marcorispoli/PCB336/README.md

NOTE DI DEBUG

17/04/2026

- Manca in Lista Parti L1.
 Aggiunto manualmente
