marcorispoli/PCB336/ESECUTIVI/LP25-336-0_ASSY00_Rev00.xlsx

Sheet: 25-336-0
LISTA PARTI 25-336-0 |  |  |  |  |  |  | DATA 19/02/2026
Pos. | Qtà | Rif | Descrizione | Value | PN Costruttore | PN Fornitore (MOUSER) | Costruttore | Package | PcbFootprint
1 | 2 | C1,C8 | MLCC - SMD/SMT 50V 0.1uF X7R 0603 10% | 100nF | C0603C104K5RACTU | 80-C0603C104K5R | KEMET |  | SMD0603
2 | 2 | C2,C5 | Cond. ELT Alluminio 50V D=8 THT | 33uF | 870575774002 | 710-870575774002 | WUERTH |  | EV8
3 | 2 | C3,C7 | MLCC - SMD/SMT 50V 1uF X7R 1206 10% | 1uF | C1206C105K5RAC | 80-C1206C105K5RAC | KEMET |  | SMD1206
4 | 1 | C4 | MLCC - SMD/SMT 50V 0.1uF X7R 0603 10% | 100nF | CC1206JRX7R9BB104 | 603-C1206JRX7R9BB104 | YAGEO |  | SMD1206
5 | 1 | C6 | MLCC - SMD/SMT 50V 10uF X7R 2220 10% | 10uF | 885012214005 | 710-885012214005 | WUERTH |  | SMD2220
6 | 1 | C9 | MLCC - SMD/SMT 50V 0.022uF X7R 0603 5% | 22nF | C0603C223J5RAC | 80-C0603C223J5RAC | KEMET |  | SMD0603
7 | 1 | C10 | MLCC - SMD/SMT 50V 470nF X7R 0603 5% | 470nF | CGA3E3X7R1H474KB | 810-CGA3E3X7R1H474KB | TDK |  | SMD0603
8 | 1 | C11 | Cond.Multilayer X7R, 50V 1210 | 2u2F | C1210C225K5RACTU | 80-C1210C225K5R | KEMET | SMD1210 | SMD1210
9 | 1 | C12 | MLCC - SMD/SMT 50V 0.010uF X7R 0603 5% | 10nF | C0603C103K5R7867 | 80-C0603C103K5R7867 | KEMET |  | SMD0603
10 | 11 | C13,C14,C17,C27,C29,C30,C31,C32,C33,C35,C36 | MLCC - SMD/SMT 50V 0.1uF X7R 0603 10% | 100nF | C0603C104K5RACTU | 80-C0603C104K5R | KEMET | SMD0603 | SMD0603
11 | 2 | C15,C16 | MLCC - SMD/SMT 50V 1nF COG(NPO) 0603 5% | 1nF | C0603C102J5RAC | 80-C0603C102J5GAL | KEMET |  | SMD0603
12 | 2 | C18,C19 | MLCC - SMD/SMT 50V 68pF COG (NP0) 0603 2% | 68pF | C0603C680G5GACTU | 80-C0603C680G5G | KEMET | SMD0603 | SMD0603
13 | 3 | C20,C21,C24 | MLCC - SMD/SMT 50V 0.1uF X7R 0603 10% | 100nF | C0603C104K5RACTU | 80-C0603C104K5R | KEMET | SMD0603 | SMD0603
14 | 4 | C22,C23,C25,C26 | Cond.Elt.Tantalio 35V SIZE C | 4u7 | T491C475K035ATAUTO | 80-T491C475K35ATAUTO | KEMET | TNT SIZE C | ETANT-C
15 | 1 | C28 | MLCC - SMD/SMT 10V 10uF X7R 0805 10% | 10uF | C0805C106K8RACTU | 80-C0805X106K8RAUTLR | KEMET | SMD0805 | SMD0805-MET
16 | 1 | C34 | MLCC - SMD/SMT 35V 4u7F X7R 1206 10% | 4u7 | C1206C475K6RACTU | 80-C1206C475K6R | KEMET | SMD1206 | SMD1206
17 | 2 | DL1,DL2 | Diodo led smd 0805 | VERDE | APTD2012LCGCK | 604-APTD2012LCGCK | KINGBRIGHT | SMD0805 | LED0805-MET-12
18 | 1 | DL3 | Diodo led smd 0805 | BLU | APT2012LVBC/D | 604-APT2012LVBCD | KINGBRIGHT | SMD0805 | LED0805-MET-12
19 | 5 | DL4,DL5,DL6,DL7,DL8 | Diodo led smd 0805 KP-2012YD | GIALLO | APTD2012LSYCK | 604-APTD2012LSYCK | KINGBRIGHT | SMD0805 | LED0805-MET-12
20 | 1 | DL9 | Diodo led smd 0805 APTD2012LSURCK | ROSSO | APTD2012LSURCK | 604-APTD2012LSURCK | KINGBRIGHT | SMD0805 | LED0805-MET-12
21 | 1 | D1 | Diodi e raddrizzatori Schottky HV Power Schottky 100Vrrm 2x10A 0.85V | MBR20100CT-G1 | MBR20100CT-G1 | 621-MBR20100CT-G1 | DIODES |  | TO220-NUM
22 | 1 | D2 | Zener Diodes ZENER 5W 51V | CZRB5369B-HF | CZRB5369B-HF | 750-CZRB5369B-HF | COMCHIP |  | SMB-2_1
23 | 1 | D3 | Diodi e raddrizzatori Schottky 1A 100V | MBRS1100T3G | MBRS1100T3G | 863-MBRS1100T3G | ONSEMI |  | SMB-2_1
24 | 1 | D4 | Diodi Zener ZENER DIODE 27V SOD123 | MMSZ5254CHE3_A-08 | MMSZ5254CHE3_A-08 | 78-MMSZ5254CHE3_A-08 | VISHAY |  | SOD123_2-1
25 | 1 | D5 | Diodi Zener ZENER DIODE 12V SOD123 | MMSZ5242C-HE3_A-08 | MMSZ5242C-HE3_A-08 | 78-MMSZ5242CHE3_A-08 | VISHAY |  | SOD123_2-1
26 | 1 | D6 | ESD Protection compatible with CAN BUS | ESD2CAN24DBZRQ1 | ESD2CAN24DBZRQ1 | 595-ESD2CAN24DBZRQ1 | TEXAS | SMD | SOT23-123
27 | 3 | D7,D8,D9 | Raddrizzatori 1.0A Rectifier UF Recovery | ES1B | ES1B | 512-ES1B | ONSEMI |  | SMA-1/2
28 | 1 | FL3 | Circuiti filtro EMI 40 DB 50V 15A LEADED | BNX012-01 | BNX012-01 | 81-BNX012-01 | MURATA |  | BNX012-01-MURATA_NEW
29 | 1 | F1 | FUSIBILE +PORTAFUSIBILE 0154005.DRT | 5A | 0154005.DRT | 576-0154005.DRT | LITTELFUSE |  | LITTELFUSE-154
30 | 2 | J1,J2 | CONN.HEADER 2X2 DRITTO P2 | NANO-FIT 105312-1104 | 105312-1104 | 538-105312-1104 | MOLEX |  | 1053121104-MOLEX
31 | 1 | J3 | Molex Minifit 2x1 | 46999-0138-MOLEX | 46999-0138 | 538-46999-0138 | Molex | Minifit46999-0138 | MOLEX-39281023
32 | 1 | J4 | Connettore ULTRAFIT 2 x 4 P.3.5 | MOLEX 172298-1108 | 172298-1108 | 538-172298-1108 | MOLEX | THT | 1722981108-MOLEX
33 | 1 | J5 | Header boxed IDC dritto 2 X 3 P.2.54 | 61200621621 | 61200621621 | 710-61200621621 | WUERTH | THT | 61200621621-WE
34 | 1 | J6 |  | HEADER 5 |  |  |  |  | 5SIP100 | NON MONTARE
35 | 3 | K1,K2,K4 | RELE' 24V 6A DOPPIO | 32.21.7.4000 | 32.21.7.4000 | FARNEL: 4244646 | FINDER |  | 32.21- FINDER
36 | 1 | K3 | RELE' STATO SOLIDO SMD | CPC1017NTR | CPC1017NTR | 849-CPC1017NTR | IXYS |  | CPC1017N-CLARE
37a | 1 | L1 | Induttori accoppiati WE-CFWI Cpld Flatwr 10uH 13A 13.9mOhms | 10uH | 74485540101 | 710-74485540101 | WUERTH | 74485540101 | WE-74485540101
37b | 1 | L2 | Filtro Modo Comune x CAN BUS | DLW32SH101XF2L | DLW32SH101XF2L | 81-DLW32SH101XF2L | MURATA | DLW32SH101XF2L | DLW32S_MURATA
38 | 1 | L3 | Induttore 8.2uH | 8.2uH | SRR4528A-8R2Y | RS:1765964 MOUSER: 652-SRR4528A-8R2Y FARNELL: | BOURNS | 5X5MM SMD | SRR4528A-BOURNS | (NOTA: trovare una alternativa)
39 | 2 | L4,L5 | Ferrite Bead | BLM18BD102 | BLM18BD102SN1D | 81-BLM18BD102SN1D | MURATA | SMD0603 | SMD0603
40 | 11 | Q1,Q3,Q4,Q5,Q6,Q7,Q8,Q9,Q10,Q11,Q12 | MOSFET CANALE N | 2N7002LT1G | 2N7002LT1G | 863-2N7002LT1G | ON | SOT23 | SOT23-123
41 | 1 | Q2 | MOSFET N-Ch 200V 36A TDSON-8 OptiMOS 3 | BSC320N20NS3GATMA1 | BSC320N20NS3GATMA1 | 726-BSC320N20NS3GATM | INFINEON | TDSON-8 | PG-TDSON-8-INFINEON
42 | 5 | R1,R43,R45,R46,R47 | Resistore thick film 1/8W 1% 0603 | 20K | AC0603FR-0720KL | 603-AC0603FR-0720KL | VARI | SMD0603 | SMD0603
43 | 1 | R2 | Resistore thick film 1/8W 1% 0603 | 38K3 | AC0603FR-0738K3L | 603-AC0603FR-0738K3L | VARI | SMD0603 | SMD0603
44 | 4 | R3,R4,R18,R19 | Resistore thick film 1/8W 1% 0603 | 4K7 | AC0603FR-074K7L | 603-AC0603FR-074K7L | VARI | SMD0603 | SMD0603
45 | 1 | R5 | Resistore thick film 1/8W 1% 0603 | 1Meg | AC0603DR-071ML | 603-AC0603DR-071ML | VARI | SMD0603 | SMD0603
46 | 7 | R6,R16,R17,R22,R24,R30,R49 | Resistore thick film 1/8W 1% 0603 | 10K | RC0603FR-0710KL | 603-RC0603FR-0710KL | VARI | SMD0603 | SMD0603
47 | 2 | R7,R8 | Resistore thick film 250mW 1% 1206 | 2R | RCC12062R00FKEA | 71-RCC12062R00FKEA | VISHAY | SMD1206 | SMD1206
48 | 1 | R9 | Resistore thick film 1/8W 1% 0603 | 100K | RC0603FR-07100KL | 603-RC0603FR-07100KL | VARI | SMD0603 | SMD0603
49 | 4 | R10,R11,R39,R48 | Resistore thick film 1/8W 1% 0603 | 1K | RC0603FR-071KL | 603-RC0603FR-071KL | VARI | SMD0603 | SMD0603
50 | 1 | R12 | Resistore thick film 1/8W 1% 0603 | 30K | AC0603DR-0730KL | 603-AC0603DR-0730KL | VARI | SMD0603 | SMD0603
51 | 1 | R13 | Resistore thick film 1/8W 1% 0603 | 196K | AC0603FR-07196KL | 603-AC0603FR-07196KL | VARI | SMD0603 | SMD0603
52 | 2 | R14,R15 | Resistore thick film 1W 1% SMD2010 | 0R01 | PE2010FKF7W0R01L | 603-PE2010FKF7W0R01L | YAGEO | SMD2010 | SMD2010
53 | 2 | R20,R21 | Resistore thick film 1/8W 1% 0603 | 0R | RC0603JR-070RL | 603-RC0603JR-070RL | VARI | SMD0603 | SMD0603
54 | 2 | R23,R27 | Resistore thick film 1/8W 1% 0603 | 560R | AC0603FR-07560RL | 603-AC0603FR-07560RL | VARI | SMD0603 | SMD0603
55 | 2 | R25,R28 | Resistore thick film 1/8W 1% 0603 | 2K7 | AC0603FR-072K7L | 603-AC0603FR-072K7L | VARI | SMD0603 | SMD0603
56 | 2 | R26,R29 | Resistore thick film 1/8W 1% 0603 | 5K6 | AC0603FR-075K6L | 603-AC0603FR-075K6L | VARI | SMD0603 | SMD0603
57 | 1 | R31 | Resistore thick film 1/8W 1% 0603 | 33R | AC0603FR-0733RL | 603-AC0603FR-0733RL | VARI | SMD0603 | SMD0603
58 | 2 | R32,R37 | Resistore thick film 1/8W 1% 0603 | 120R | RC0603FR-13120RL | 603-RC0603FR-13120RL | VARI | SMD0603 | SMD0603
58b | 1 | R35 | Resistore thick film 1/8W 1% 0603 | 120R | RC0603FR-13120RL | 603-RC0603FR-13120RL | VARI | SMD0603 | SMD0603 | NON MONTARE
59 | 3 | R33,R34,R36 | Resistore thick film 1/8W 1% 0603 | 470R | RC0603FR-07470RL | 603-RC0603FR-07470RL | VARI | SMD0603 | SMD0603
60 | 1 | R38 | Resistore thick film 1/8W 1% 0603 | 3K3 | RC0603FR-133K3L | 603-RC0603FR-133K3L | VARI | SMD0603 | SMD0603
61 | 1 | R40 | Resistore thick film 1/4W 1% 0603 | 0R | RC1206FR-070RL | 603-RC1206FR-070RL | VARI | SMD1206 | SMD1206
62 | 2 | R41,R42 | Resistore thick film 1W 1% 2512 | 4R7 | AC2512JK-074R7L | 603-AC2512JK-074R7L | VARI | SMD2512 | SMD2512
63 | 1 | R44 | Resistore thick film 1/8W 1% 0603 | 100R | TR0603MR-07100RL | 603-TR0603MR-07100RL | VARI | SMD0603 | SMD0603
64 | 1 | R50 | Resistore thick film 1/8W 1% 0603 | 330R | AC0603FR-07330RL | 603-AC0603FR-07330RL | VARI | SMD0603 | SMD0603
65 | 7 | R51,R53,R54,R55,R56,R57,R58 | Resistore thick film 1/8W 1% 0603 | 680R | RC0603FR-07680RL | 603-RC0603FR-07680RL | VARI | SMD0603 | SMD0603
66 | 7 | R52,R59,R60,R61,R62,R63,R64 | Resistore thick film 1/8W 1% 0603 | 33K | RC0603FR-1033KL | 603-RC0603FR-1033KL | VARI | SMD0603 | SMD0603
67 | 7 | TP1,TP2,TP3,TP4,TP5,TP6,TP7 | Torretta x Test Point foro pcb 1mm | 20-2137 | 20-2137 | FARNELL:8731128 RS:101-2391 | TRUE | THT | TESTPOINT_1MM | NON MONTARE
68 | 1 | U1 | Board Mount Current Sensors 80ARMS 500kHz Hall-e ffect current sensor | TMCS1126C5BQDVGR | TMCS1126C5BQDVGR | 595-TMCS1126C5BQDVGR | TEXAS |  | DVG0010A
69 | 1 | U2 | Controller di commutazione Low-IQ, 2MHz 60V iso lated SEPIC FLYBACK | LT8357EMSE#PBF | LT8357EMSE#PBF | 584-LT8357EMSE#PBF | ANALOG DEVICE | MSOP-12 | MSE-12 PIN-EP
70 | 2 | U3,U4 | Optoisolatore singolo | TCMT1103 | TCMT1103 | 782-TCMT1103 | VISHAY | HALF PITCH MINI-FLAT | SSOP4
71 | 2 | U5,U6 | Amplificatori operazionali - Amp. op. Dual Low Power | LM358PT | LM358P | 511-LM358P | ST |  | SOG.65M/8/WG6.40/L3.00
72 | 1 | U7 | CAN TRANSCEIVER | TJA1050T | TJA1050T | 771-TJA1050T/CM,118 | NXP | SOIC-8 | SO8
73 | 1 | U8 | DC/DC 5V 500mA | TSR 0.5-2450 | TSR 0.5-2450 | 495-TSR0.5-2450 | TRACO POWER | THT | TSR-0.5-TRACO
74 | 1 | U9 | 3.3VDC LDO | NCP1117ST33T3G | NCP1117ST33T3G | 863-NCP1117ST33T3G | ON | SOT223 | SOT223-1234
75 | 1 | U10 | 32bit ARM 4F 1MB Flash, 256K Ram, 2xCAN-FD | SAME51J20A-A | SAME51J20A-A | 556-ATSAME51J20A-AF | MICROCHIP | TQFP | QUAD.50M/64/WG12.00
76 | 1 | RAD1 | DISSIPATORE PER TO220 | AAVID 513102B02500G | 513102B02500G | 532-513102B25 | AAVID

Sheet: Revision
LISTA PARTI PCB/25-336-0 | REV 00
ASSY_00
Change Log | Rev | Descrizione
2026-02-23 | 0 | Prima emissione: - R35: (can bus) non montare. - Test points: non montare, si usano solo le piazzole - J6: non momtare. E' una predisposizione per una scheda aggiuntiva per la tensione di griglia
