marcorispoli/PCB336/KiCad/PCB336.csv

# | Qty | Qty x3 schede | N acquisto | Value | Mouser Part Number | Farnell Part Number
1 | 28 | 84 | 85 | 100nF | 71-VJ0805Y104KXACWBC
2 | 1 | 3 | 5 | 4u7 | 80-C1206C475K6R
3 | 2 | 6 | 10 | 10nF | 80-C0805C103J5G
4 | 1 | 3 | 5 | 10uF | 581-KGM21AR51A106MU
5 | 2 | 6 | 10 | 10uF | 80-C1206C106K3PAC
6 | 9 | 27 | 30 | 1uF | 187-CL31A105KB9LNNC
7 | 1 | 3 | 5 | 100pF | 581-06035U101KAT2A
8 | 1 | 3 | 5 | 470pF | 80-C0603C471J5GAUTO
9 | 2 | 6 | 10 | 100uF | 667-EEU-EE2D101S
10 | 1 | 3 | 5 | 47nF | 581-KAM21BR71H473KT
11 | 8 | 24 | 25 | GREEN | 859-LTST-C171TGKT
12 | 1 | 3 | 5 | BLUE | 859-LTST-C170TBKT
13 | 1 | 3 | 5 | RED | 859-LTST-C170KRKT
14 | 8 | 24 | 25 | YELLOW | 859-LTST-C170KSKT
15 | 10 | 30 | 30 | 1N4148W | 637-1N4148W
16 | 4 | 12 | 15 | ES1A | 512-ES1A
17 | 1 | 3 | 5 | 39-29-9043 | 538-39-29-9043
18 | 1 | 3 | 5 | Piazzolato
19 | 4 | 12 | 15 | 32.21.7.024.4000 |  | 4244646
20 | 11 | 33 | 35 | 2N7002LT1G | 863-2N7002LT3G
21 | 3 | 9 | 10 | 4K7 | 71-CRCW0805-4.7K-E3
22 | 1 | 3 | 5 | 866R | 603-RC0805FR-07866RL
23 | 14 | 42 | 45 | 10K | 603-RC0603FR-0710KL
24 | 1 | 3 | 5 | 330R | 603-AF0603FR-07330RL
25 | 3 | 9 | 10 | 1K | 603-RC0603FR-101KL
26 | 10 | 30 | 30 | 680R | 603-AF0603FR-07680RL
27 | 6 | 18 | 20 | 33K | 603-RV0603JR-0733KL
28 | 6 | 18 | 20 | 5K6 | 603-AF0603FR-075K6L
29 | 1 | 3 | 5 | 220R | 603-RC0603FR-07220RL
30 | 2 | 6 | 10 | 2K | 603-RE0603DRE072KL
31 | 1 | 3 | 5 | 56K | 603-AC0603FR-1356KL
32 | 2 | 6 | 10 | 2K2 | 603-AA0603FR-072K2L
33 | 2 | 6 | 10 | 4K7 | 603-RC1206FR-074K7L
34 | 2 | 6 | 10 | 200R | 603-AF0603FR-07200RL
35 | 2 | 6 | 10 | 27K | 603-AF0603FR-0727KL
36 | 2 | 6 | 10 | 86K6 | 603-RC0603FR-0786K6L
37 | 1 | 3 | 5 | 39K | 603-AF0603FR-0739KL
38 | 3 | 9 | 10 | 4K7 | 603-RC0603FR-074K7L
39 | 1 | 3 | 5 | 18K | 603-RC0603FR-1018KL
40 | 3 | 9 | 10 | 100K | 603-RC0603FR-07100KL
41 | 1 | 3 | 5 | 22K | 603-RC0603FR-1022KL
42 | 1 | 3 | 5 | 10R | 571-SMW210RJT
43 | 5 | 15 | 15 | 120R | 603-RC0603FR-10120RL
44 | 1 | 3 | 5 | 1K | 603-RC0805FR-071KL
45 | 1 | 3 | 5 | 33R | 603-RC0805FR-0733RL
46 | 1 | 3 | 5 | 0R | 603-RC0603JR-070RL
47 | 2 | 6 | 10 | 2K2 | 603-AF0805JR-072K2L
48 | 1 | 3 | 5 | 680R | 603-AF0805FR-07680RL
49 | 1 | 3 | 5 | 20K | 652-3296W-1-203LF
50 | 1 | 3 | 5 | 5K | 652-3296W-1-502LF
51 | 1 | 3 | 5 | TF-108
52 | 1 | 3 | 5 | NCP1117ST33T3G | 863-NCP1117ST33T3G
53 | 1 | 3 | 5 | ATSAME51J20A-A | 556-ATSAME51J20A-AF
54 | 1 | 3 | 5 | PCB319-2
55 | 1 | 3 | 5 | TME-0505S
56 | 1 | 3 | 5 | MAX22246CAWA_V+ | 700-MAX22246CAWA/V+
57 | 2 | 6 | 10 | ADM4857ARZ-REEL7 | 584-ADM4857ARZ-R7
58 | 1 | 3 | 5 | ADUM3195BRQZ | 584-ADUM3195BRQZ
59 | 1 | 3 | 5 | SRR4828A-8R2Y | 652-SRR4828A-8R2Y
60 | 10 | 30 | 30 | 4.7uF | 80-T491C475K035
61 | 6 | 18 | 20 | 5000 | 534-5000
62 | 3 | 9 | 10 | 5001 | 534-5001
63 | 6 | 18 | 20 | 5002 | 534-5001
64 | 2 | 6 | 10 | 0154003.DRT | 576-0154003.DRT
65 | 1 | 3 | 5 | XR2206CP-F | 701-XR2206CP-F
66 | 1 | 3 | 5 | MCP4821-E/MS | 579-MCP4821-E/MS
67 | 1 | 3 | 5 | 105310-2210 | 538-105310-2210
68 | 2 | 6 | 10 | 105312-1104 | 538-105312-1104
69 | 1 | 3 | 5 | MOLEX_172298-1108 | 538-172298-1108
70 | 2 | 6 | 10 | BLM18BD102SN1D | 81-BLM18BD102SN1D
71 | 2 | 6 | 10 | BNX012-01 | 81-BNX012-01
72 | 2 | 6 | 10 | BAT754S,215 | 771-BAT754S-T/R
73 | 1 | 3 | 5 | MMBZ6V2AL,215 | 771-MMBZ6V2AL215
74 | 1 | 3 | 5 | NJM78L12UA-TE1 | 513-NJM78L12UA-TE1
75 | 1 | 3 | 5 | NJM79L12SU3-TE1 | 513-NJM78L12UA-TE1
76 | 1 | 3 | 5 | NJM78L05UA-TE1 | 513-NJM78L05UA-TE1
77 | 1 | 3 | 5 | TJA1050T_CM,118 | 771-TJA1050T/CM118
78 | 2 | 6 | 10 | SK56C | 821-SK56C
79 | 1 | 3 | 5 | ESD2CAN24DBZRQ1 | 595-ESD2CAN24DBZRQ1
80 | 1 | 3 | 5 | ISO6742FDWR | 595-ISO6742FDWR
81 | 1 | 3 | 5 | LM1458MX_NOPB | 926-LM1458MX/NOPB
82 | 1 | 3 | 5 | LM358BAIDR | 595-LM358BAIDR
83 | 1 | 3 | 5 | TSR_0.5-2450 | 495-TSR0.5-2450
84 | 1 | 3 | 5 | 61200621621 | 710-61200621621
85 | 8 | 24 | 25 | 33uF | 710-870575774002
86 | 1 | 3 | 5 | 470pF | 710-8853522110011
