marcorispoli/PCB336/KiCad/METSTEP/XR2206CP-F.stp

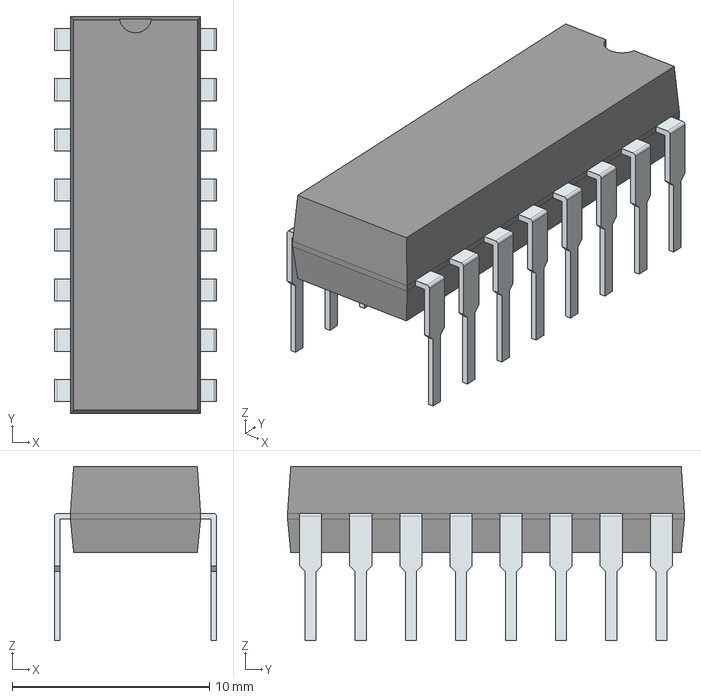
[picture p1: CAD file, 2026-08-05]
KiCad/METSTEP/XR2206CP-F.stp
8.22 x 20.1 x 8.83 mm
PinsArrayLR
