marcorispoli/PCB336/KiCad/PCB336/ESECUTIVI/PCB336-In2_Cu.dxf

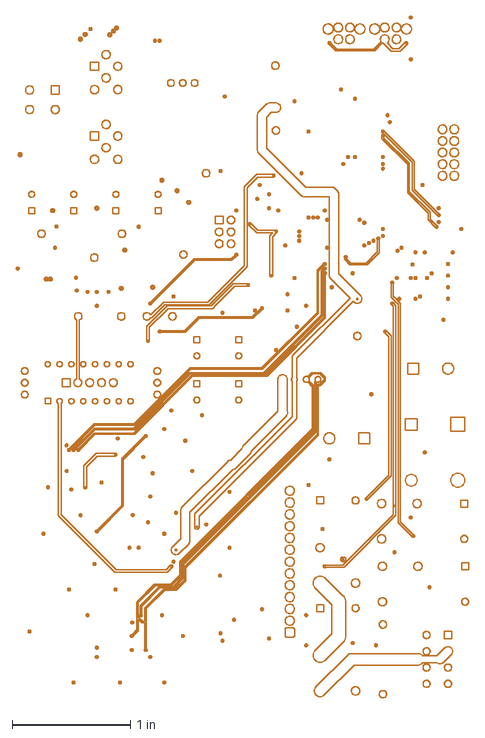
[picture p2: CAD file, 2026-09-14]
KiCad/PCB336/ESECUTIVI/PCB336-In2_Cu.dxf
3.83 x 5.77 in
