marcorispoli/PCB336/KiCad/METSTEP/BLM18BD102SN1D.stp

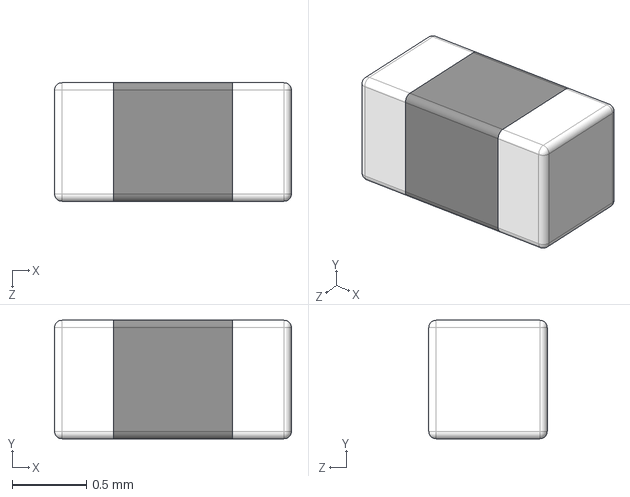
[picture p3: CAD file, 2026-08-05]
KiCad/METSTEP/BLM18BD102SN1D.stp
1.60 x 0.8 x 0.8 mm
