marcorispoli/PCB336/KiCad/PCB336/ESECUTIVI/PCB336-Edge_Cuts.dxf

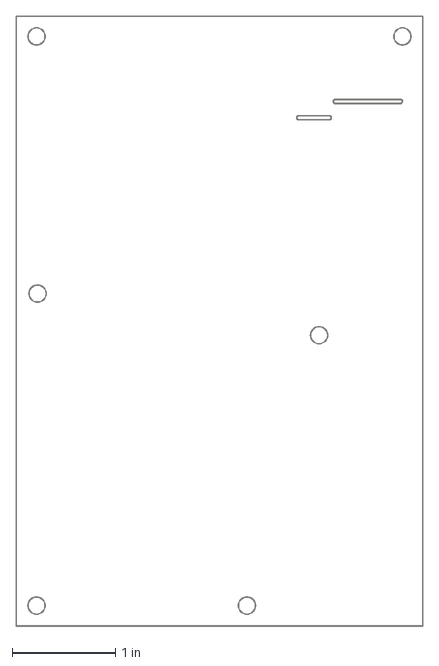
[picture p4: CAD file, 2026-09-14]
KiCad/PCB336/ESECUTIVI/PCB336-Edge_Cuts.dxf
3.94 x 5.91 in
