marcorispoli/PCB336/KiCad/METSTEP/uCProg_61200621621.stp

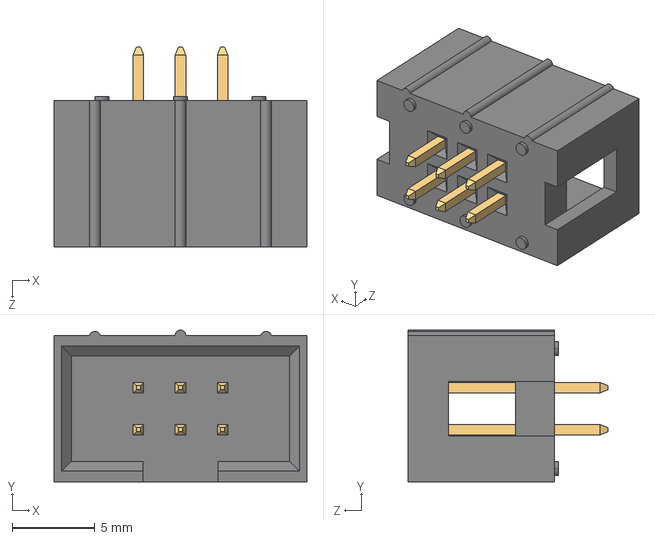
[picture p5: CAD file, 2026-08-05]
KiCad/METSTEP/uCProg_61200621621.stp
15.3 x 9.18 x 12.1 mm
6120xx21621_PIN x 6
