marcorispoli/PCB336/KiCad/METSTEP/SRR4828A-8R2Y.stp

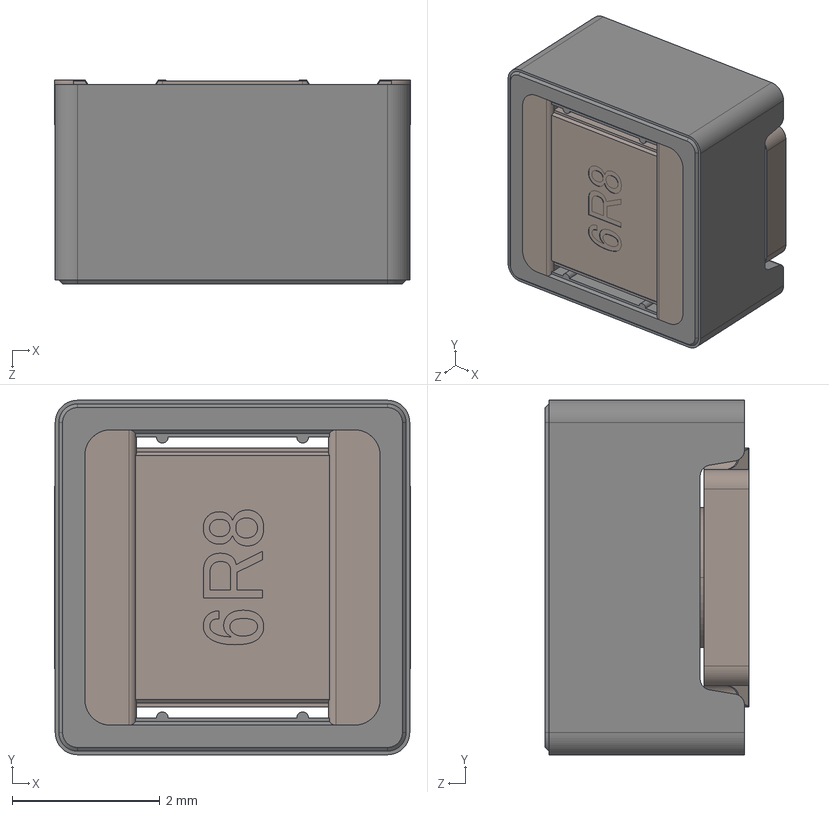
[picture p6: CAD file, 2026-08-03]
KiCad/METSTEP/SRR4828A-8R2Y.stp
4.82 x 4.80 x 2.76 mm
