marcorispoli/PCB336/KiCad/METSTEP/NJM78L12UA-TE1.stp

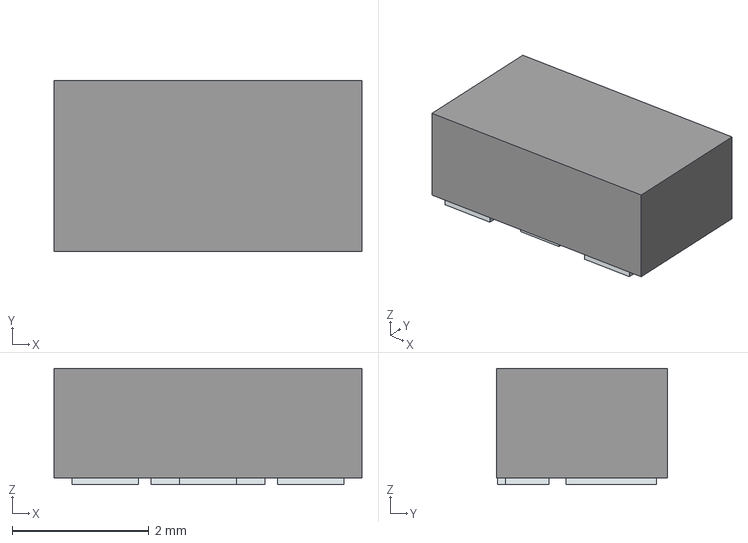
[picture p7: CAD file, 2026-08-03]
KiCad/METSTEP/NJM78L12UA-TE1.stp
4.50 x 2.50 x 1.70 mm
Pins
