marcorispoli/PCB336/KiCad/METSTEP/39-29-9043.stp

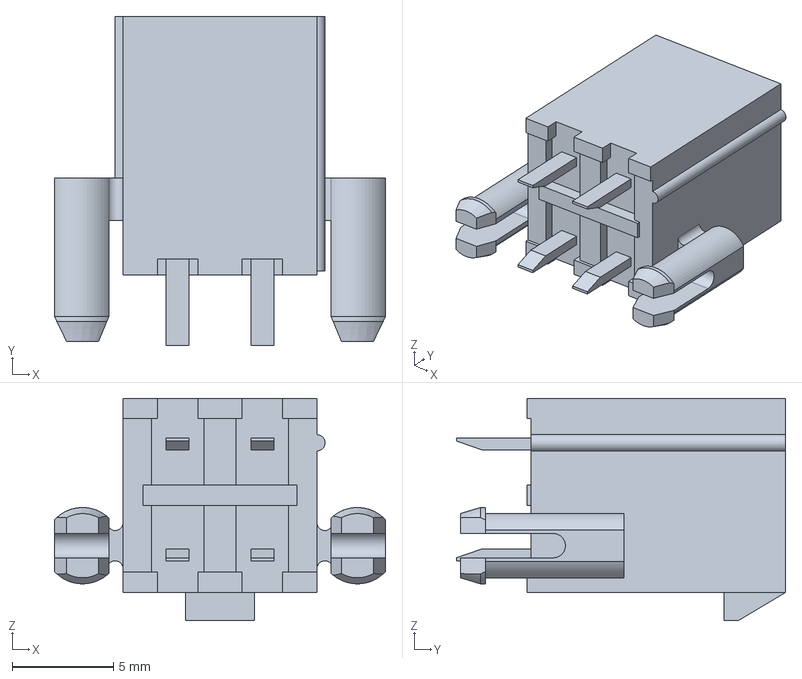
[picture p8: CAD file, 2026-08-03]
KiCad/METSTEP/39-29-9043.stp
16.4 x 16.3 x 11.0 mm
