marcorispoli/PCB336/KiCad/METSTEP/BNX012-01.stp

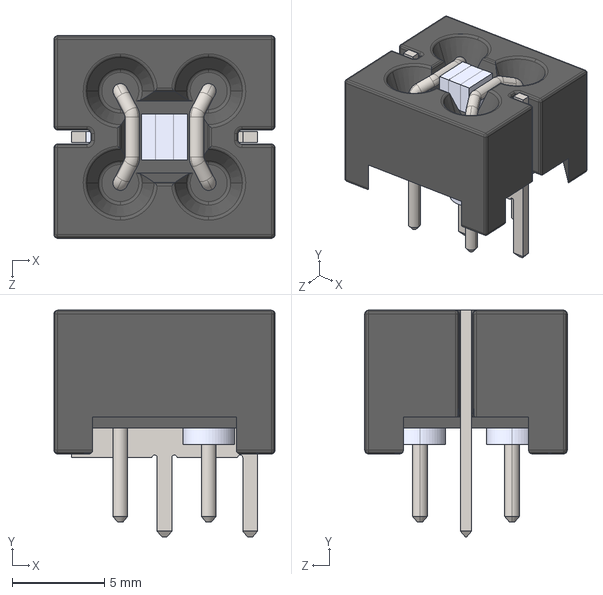
[picture p9: CAD file, 2026-08-03]
KiCad/METSTEP/BNX012-01.stp
12.0 x 12.3 x 11.0 mm
