marcorispoli/PCB336/KiCad/METSTEP/Littlefuse_serie_xxx154.DRT.stp

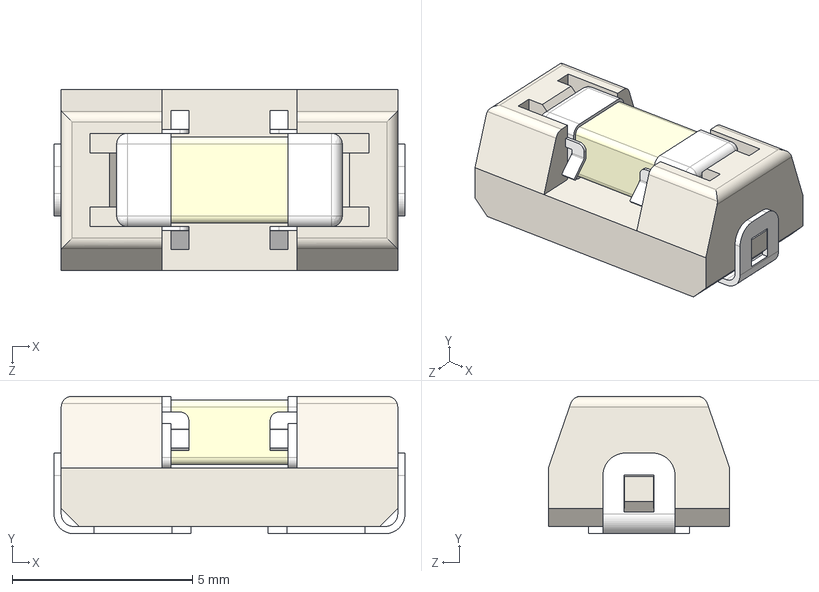
[picture p10: CAD file, 2026-08-03]
KiCad/METSTEP/Littlefuse_serie_xxx154.DRT.stp
9.73 x 3.81 x 5.03 mm
0154002.DR_2
0154002.DR_8
0154002.DR_4
0154002.DR_5
0154002.DR_9
0154002.DR_1
0154002.DR_6
0154002.DR
0154002.DR_7
0154002.DR_3
