marcorispoli/PCB336/KiCad/METSTEP/WCAP-HTG5_D8_H9_P3.5.stp

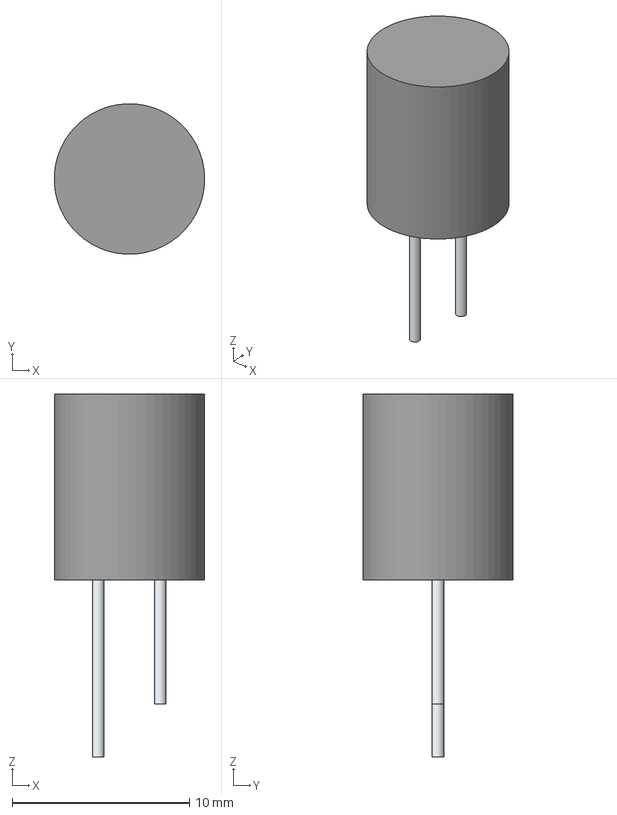
[picture p11: CAD file, 2026-08-03]
KiCad/METSTEP/WCAP-HTG5_D8_H9_P3.5.stp
8.49 x 8.50 x 20.5 mm
SimpleBody
Pin1
Pin2
