marcorispoli/PCB336/KiCad/METSTEP/TSR_0.5-2450.stp

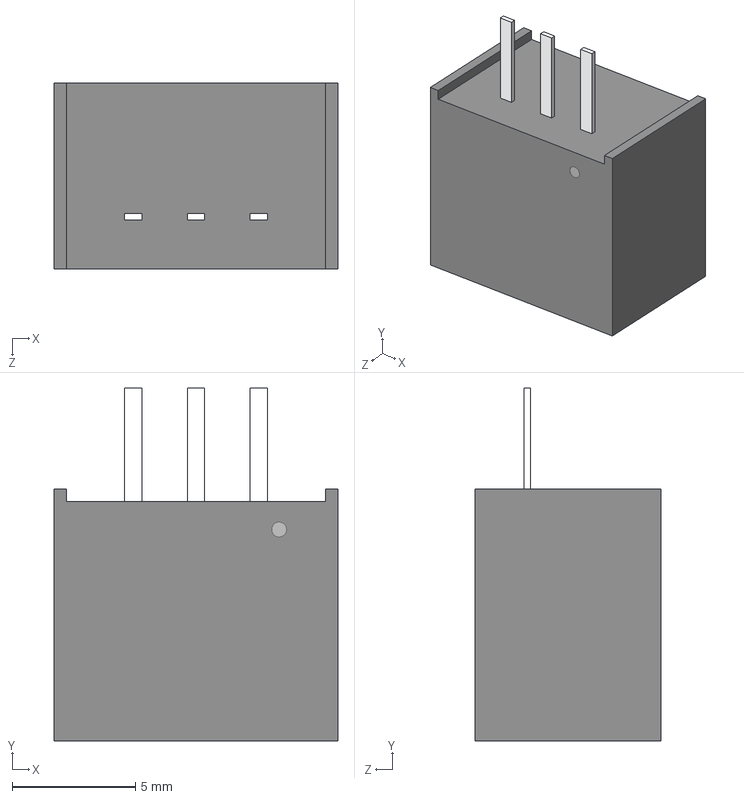
[picture p12: CAD file, 2026-08-03]
KiCad/METSTEP/TSR_0.5-2450.stp
11.5 x 14.3 x 7.55 mm
