marcorispoli/PCB336/KiCad/METSTEP/TP_5001.stp

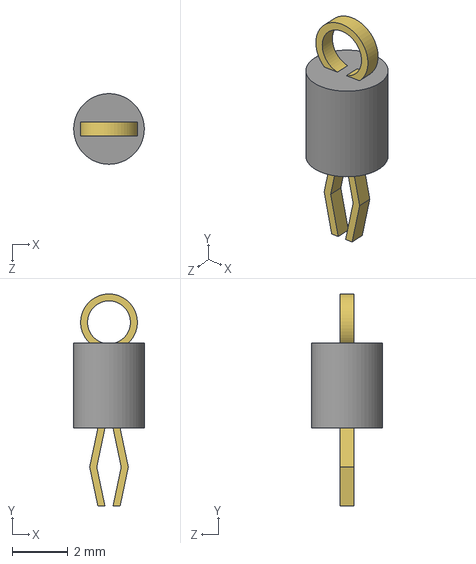
[picture p13: CAD file, 2026-08-03]
KiCad/METSTEP/TP_5001.stp
2.54 x 7.62 x 2.54 mm
