marcorispoli/PCB336/KiCad/METSTEP/T491C475K035AT.stp

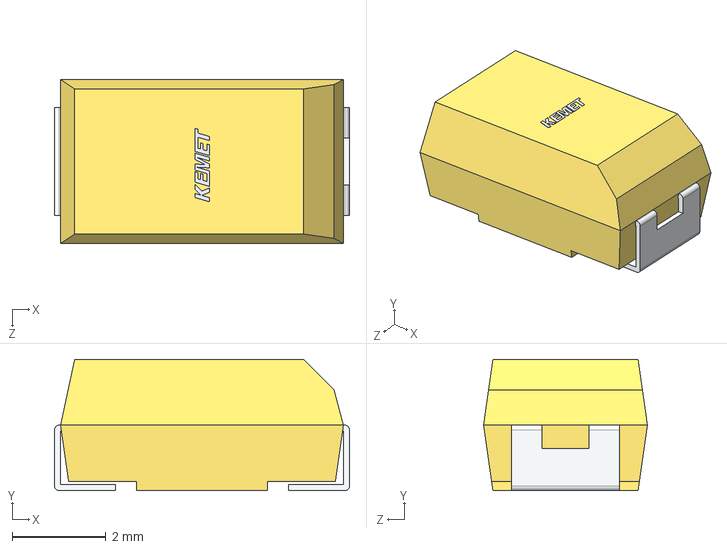
[picture p14: CAD file, 2026-08-03]
KiCad/METSTEP/T491C475K035AT.stp
6.30 x 2.81 x 3.50 mm
