marcorispoli/PCB336/KiCad/METSTEP/39-29-6108.stp

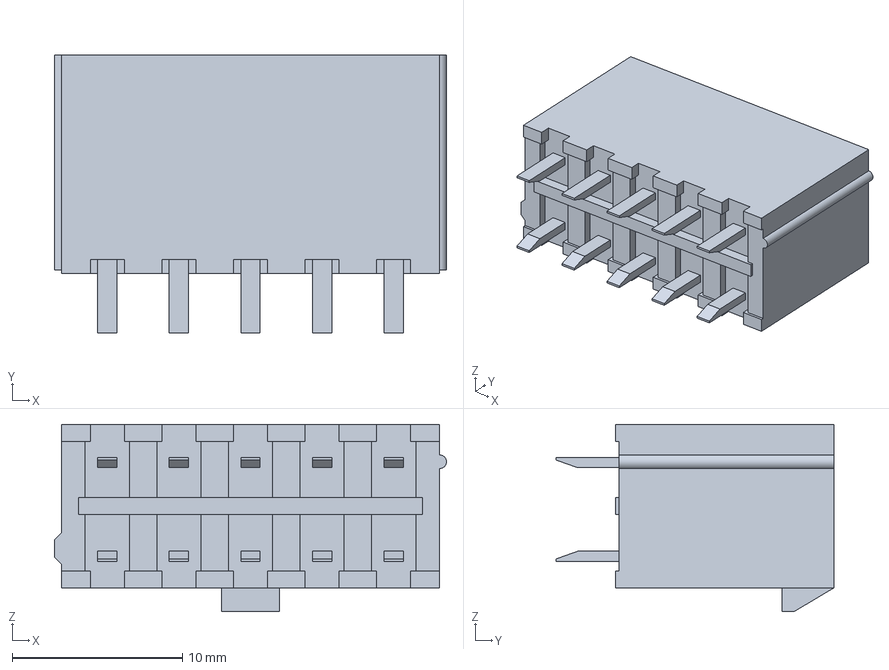
[picture p15: CAD file, 2026-08-03]
KiCad/METSTEP/39-29-6108.stp
23.0 x 16.3 x 11.0 mm
