marcorispoli/PCB336/KiCad/METSTEP/Nanofit-10-nolock.stp

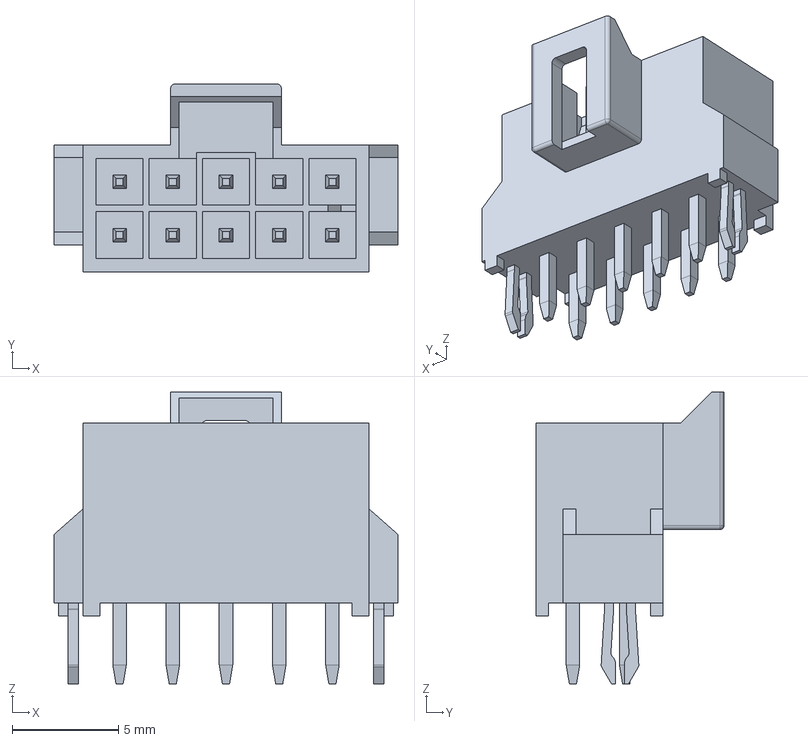
[picture p16: CAD file, 2026-08-03]
KiCad/METSTEP/Nanofit-10-nolock.stp
16.2 x 8.84 x 13.7 mm
