marcorispoli/PCB336/KiCad/METSTEP/phoenix_1986097.stp

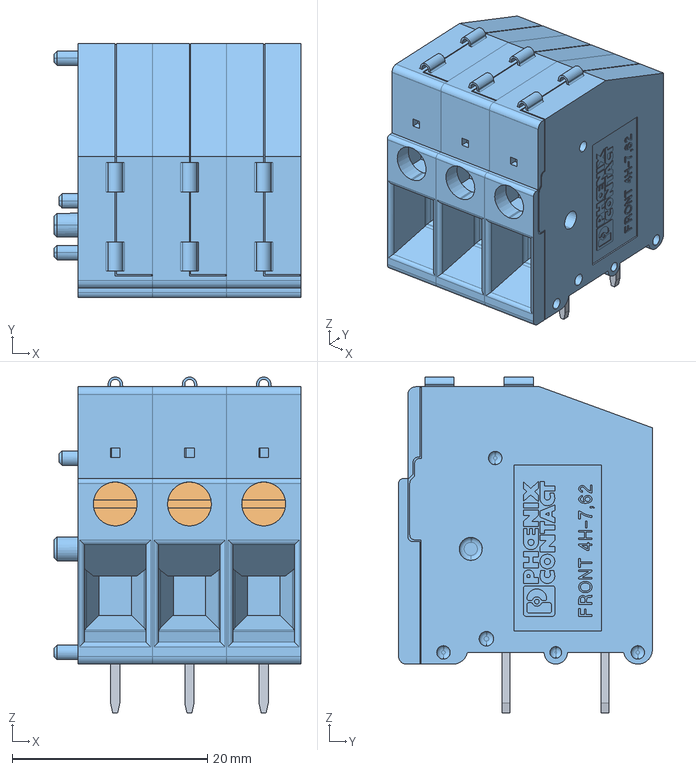
[picture p17: CAD file, 2026-08-03]
KiCad/METSTEP/phoenix_1986097.stp
25.2 x 26.0 x 34.4 mm
