marcorispoli/PCB336/KiCad/METSTEP/MOLEX_39-29-1108.stp

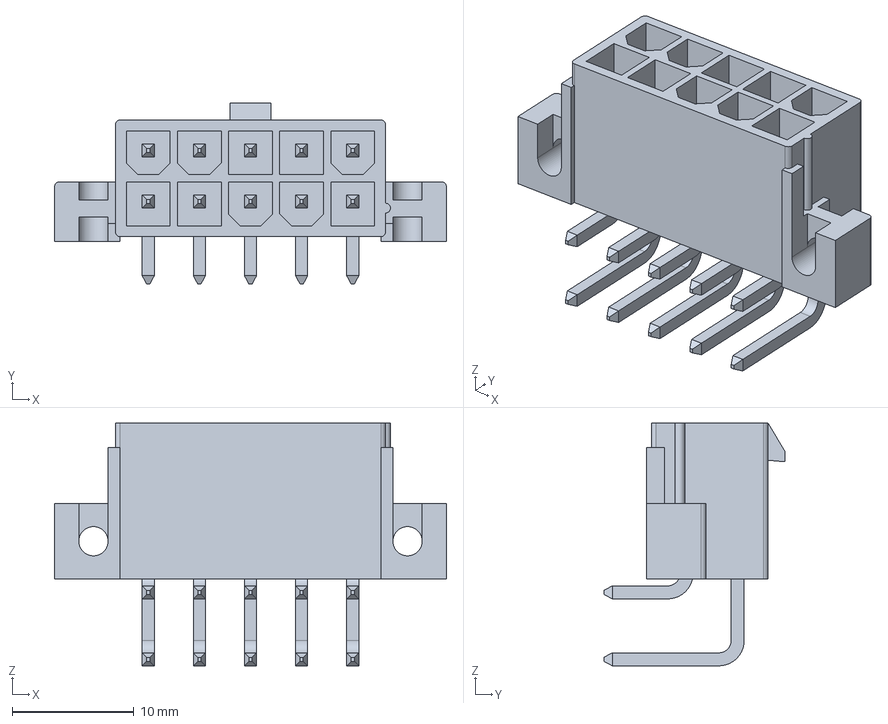
[picture p18: CAD file, 2026-08-03]
KiCad/METSTEP/MOLEX_39-29-1108.stp
32.2 x 14.9 x 19.9 mm
