marcorispoli/PCB336/KiCad/METSTEP/39-30-1102.stp

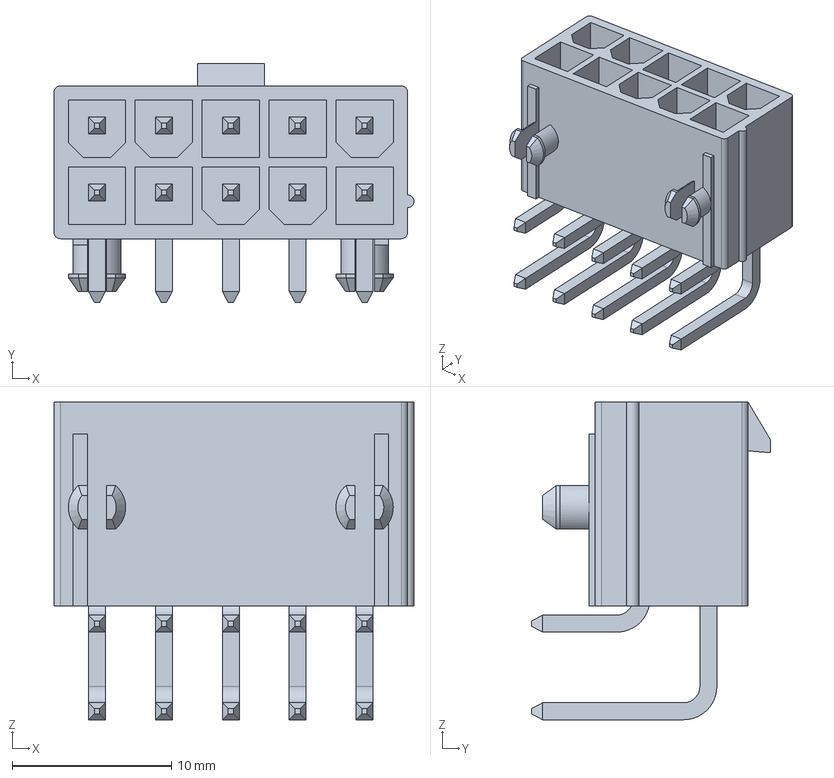
[picture p19: CAD file, 2026-08-03]
KiCad/METSTEP/39-30-1102.stp
22.6 x 15.0 x 19.9 mm
