marcorispoli/PCB336/KiCad/METSTEP/Nanofit-105310-1110.stp

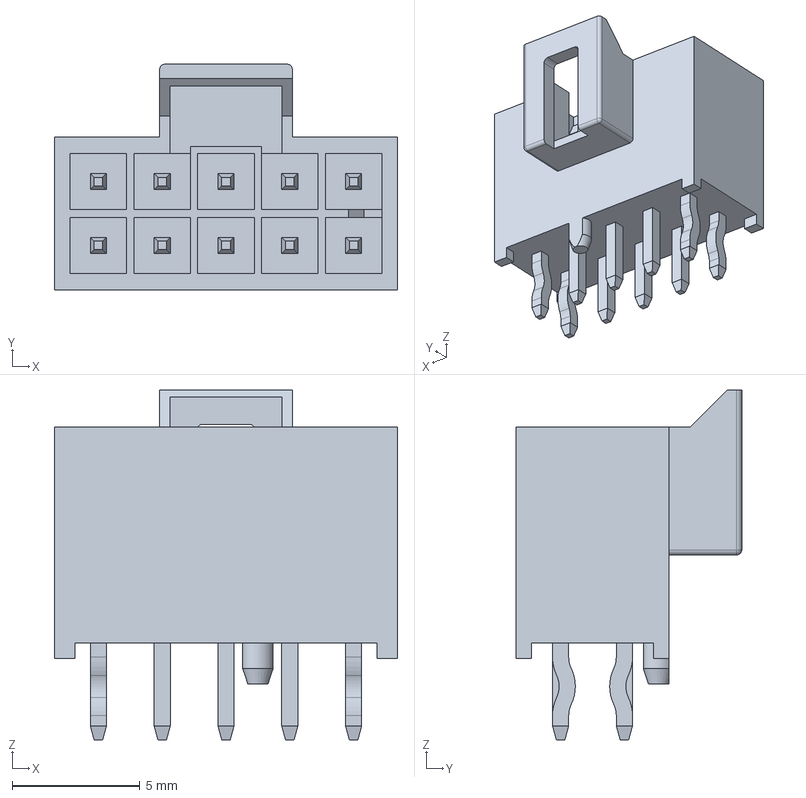
[picture p20: CAD file, 2026-08-03]
KiCad/METSTEP/Nanofit-105310-1110.stp
13.4 x 8.84 x 13.7 mm
