marcorispoli/PCB336/KiCad/METSTEP/IXFN38N100P.stp

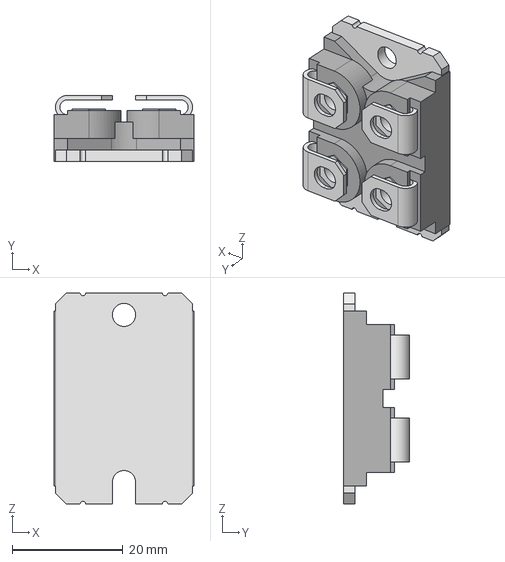
[picture p21: CAD file, 2026-08-03]
KiCad/METSTEP/IXFN38N100P.stp
25.3 x 11.9 x 38.1 mm
