marcorispoli/PCB336/KiCad/METSTEP/MOLEX_MINIFIT_87427-1012.stp

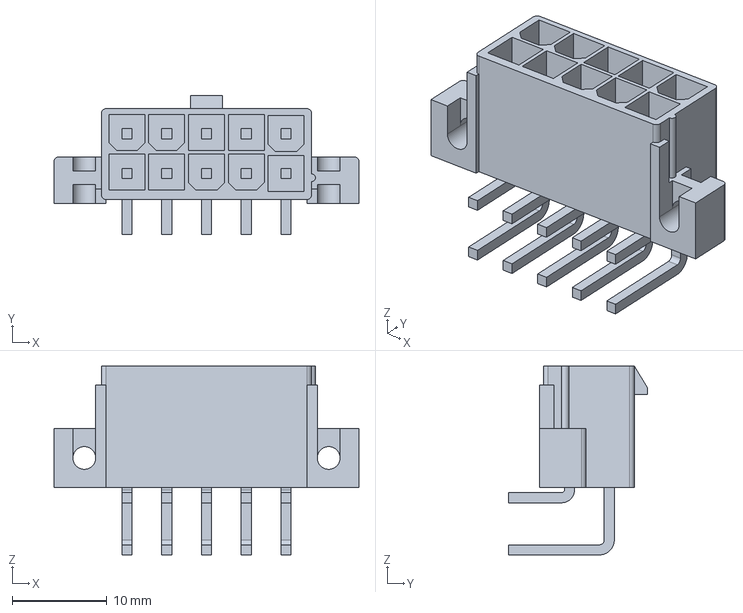
[picture p22: CAD file, 2026-08-03]
KiCad/METSTEP/MOLEX_MINIFIT_87427-1012.stp
32.2 x 14.7 x 19.9 mm
