marcorispoli/PCB336/KiCad/METSTEP/TF-138-T.step

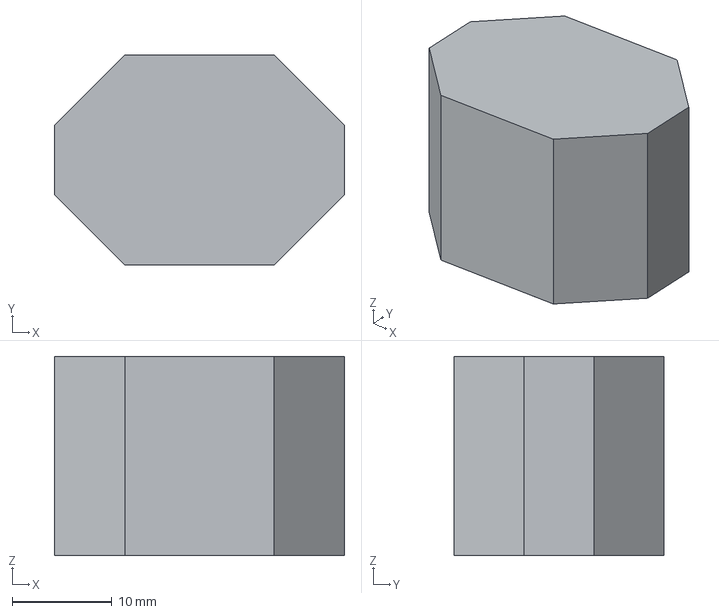
[picture p23: CAD file, 2026-08-03]
KiCad/METSTEP/TF-138-T.step
29.1 x 21.1 x 20.0 mm
