marcorispoli/PCB336/KiCad/METSTEP/MOLEX-389690002.step

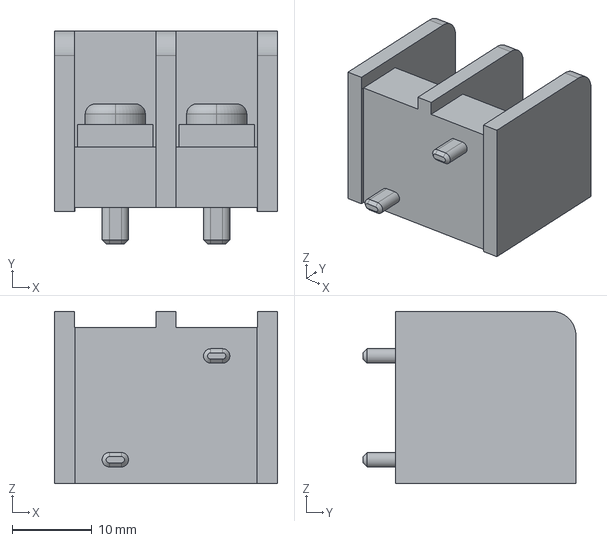
[picture p24: CAD file, 2026-08-03]
KiCad/METSTEP/MOLEX-389690002.step
27.9 x 26.7 x 21.6 mm
