marcorispoli/PCB336/KiCad/METSTEP/TF139L.step

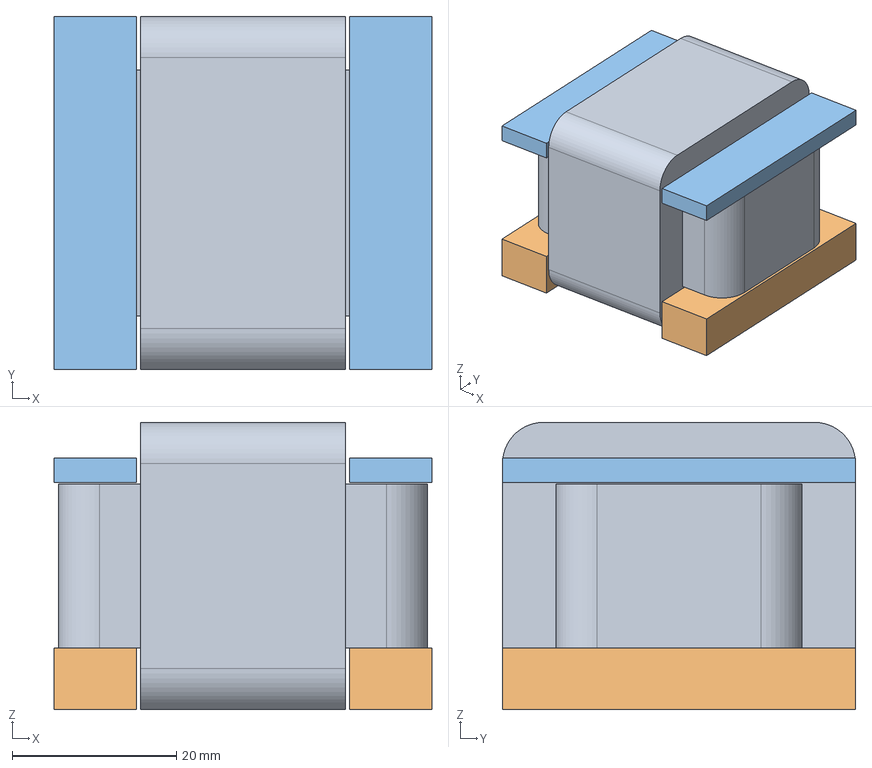
[picture p25: CAD file, 2026-08-03]
KiCad/METSTEP/TF139L.step
46.0 x 43.0 x 35.0 mm
Corpo
Corpo001
Corpo002
Corpo003
Corpo004
