marcorispoli/PCB336/(list of files, cad)

Other CAD files:
ESECUTIVI/PM25-336-0.dwg
KiCad/ESECUTIVI/GRAFICA/PCB336.dxf
LAYOUT/25-336-0.dwg
ESECUTIVI/PF25-336-0.dwg
KiCad/METSTEP/NH05050R00FE02.stp
KiCad/METSTEP/hexagonal_head_bolt_M4x16.step
KiCad/PCB336/ESECUTIVI/PCB336-B_Silkscreen.dxf
