marcorispoli/PCB336/ESECUTIVI/PF25-336-0.pdf

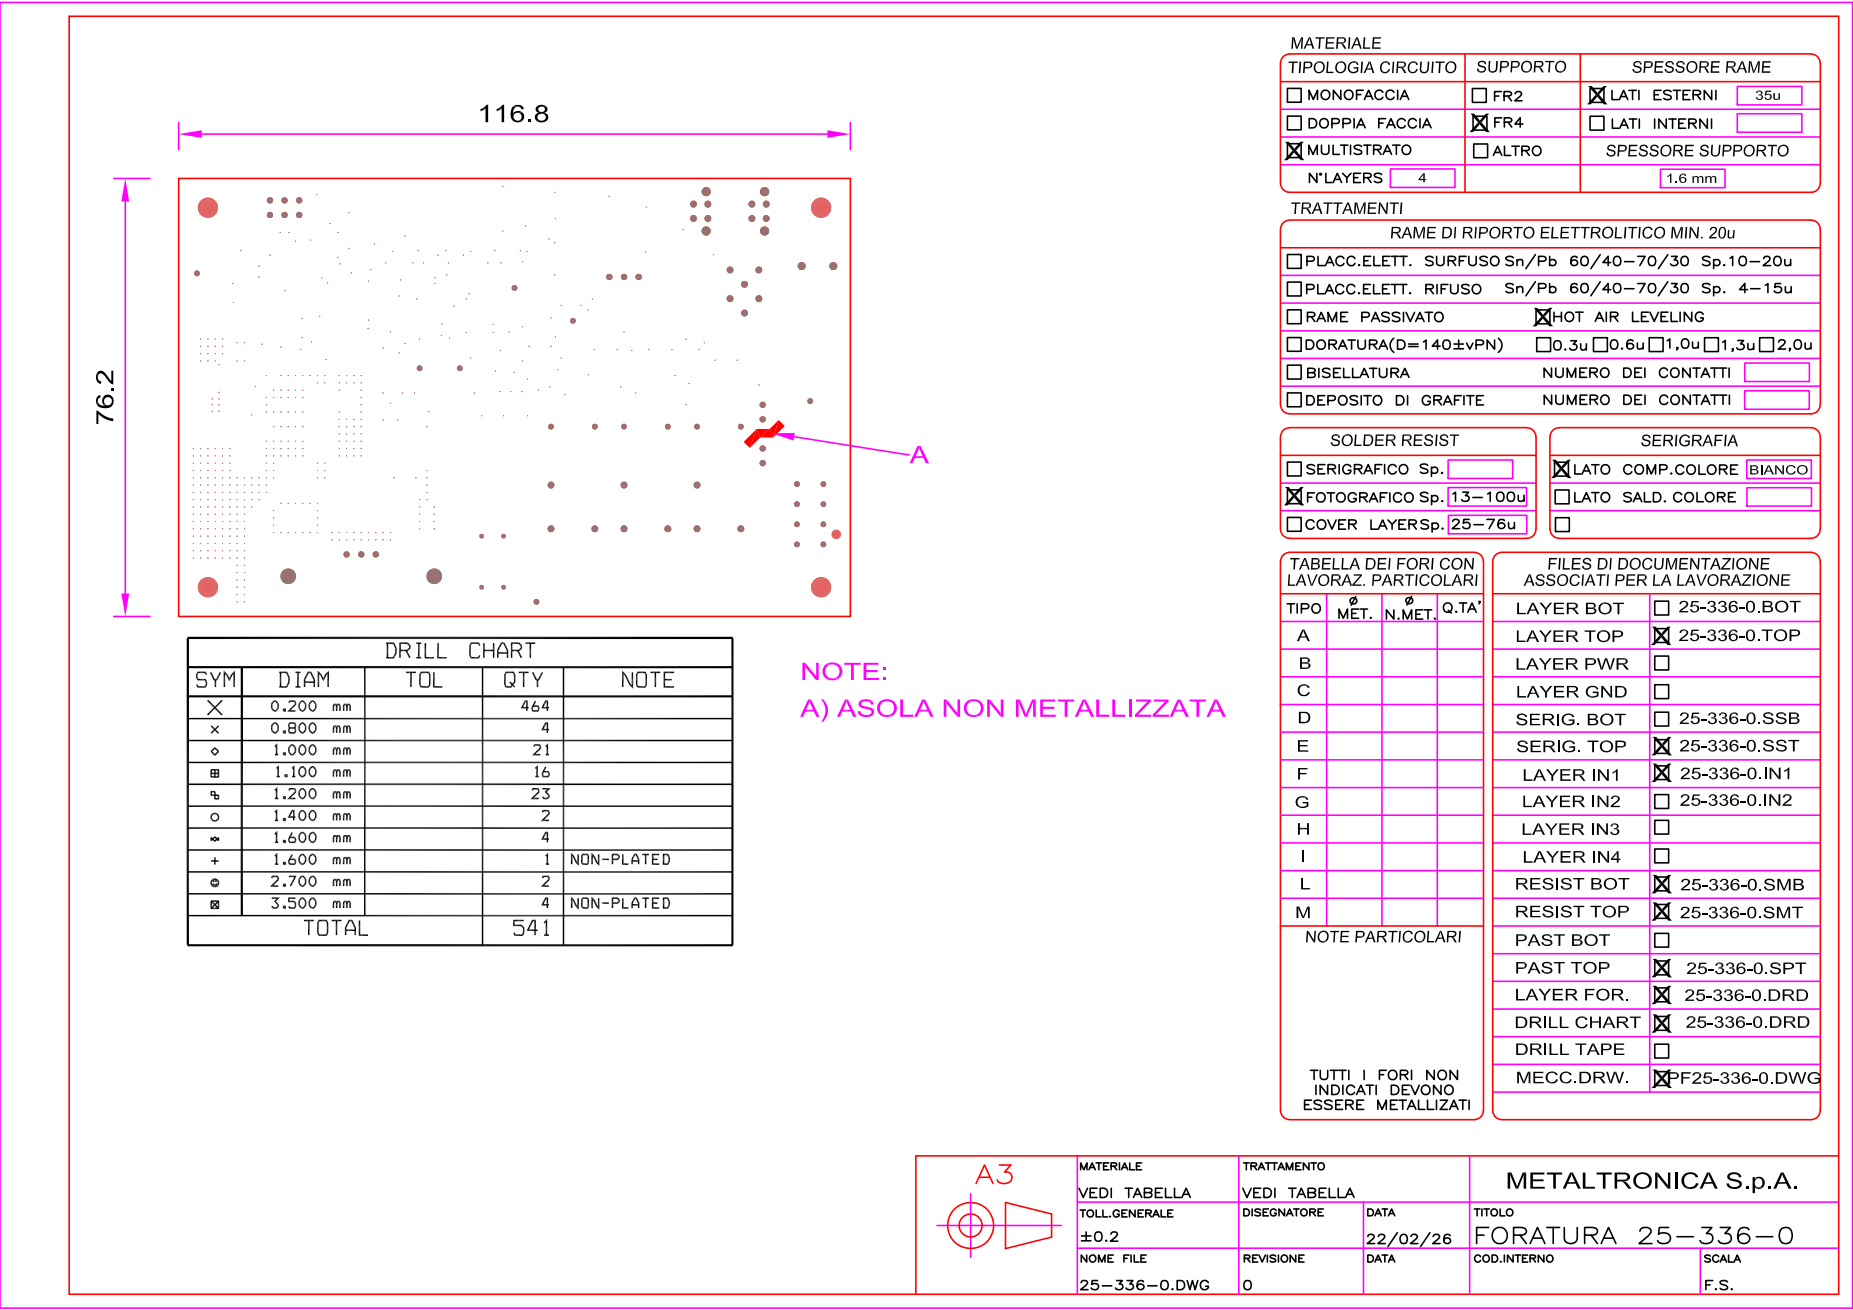
[picture p26: page 1]
