marcorispoli/PCB336/ESECUTIVI/PM25-336-0.pdf

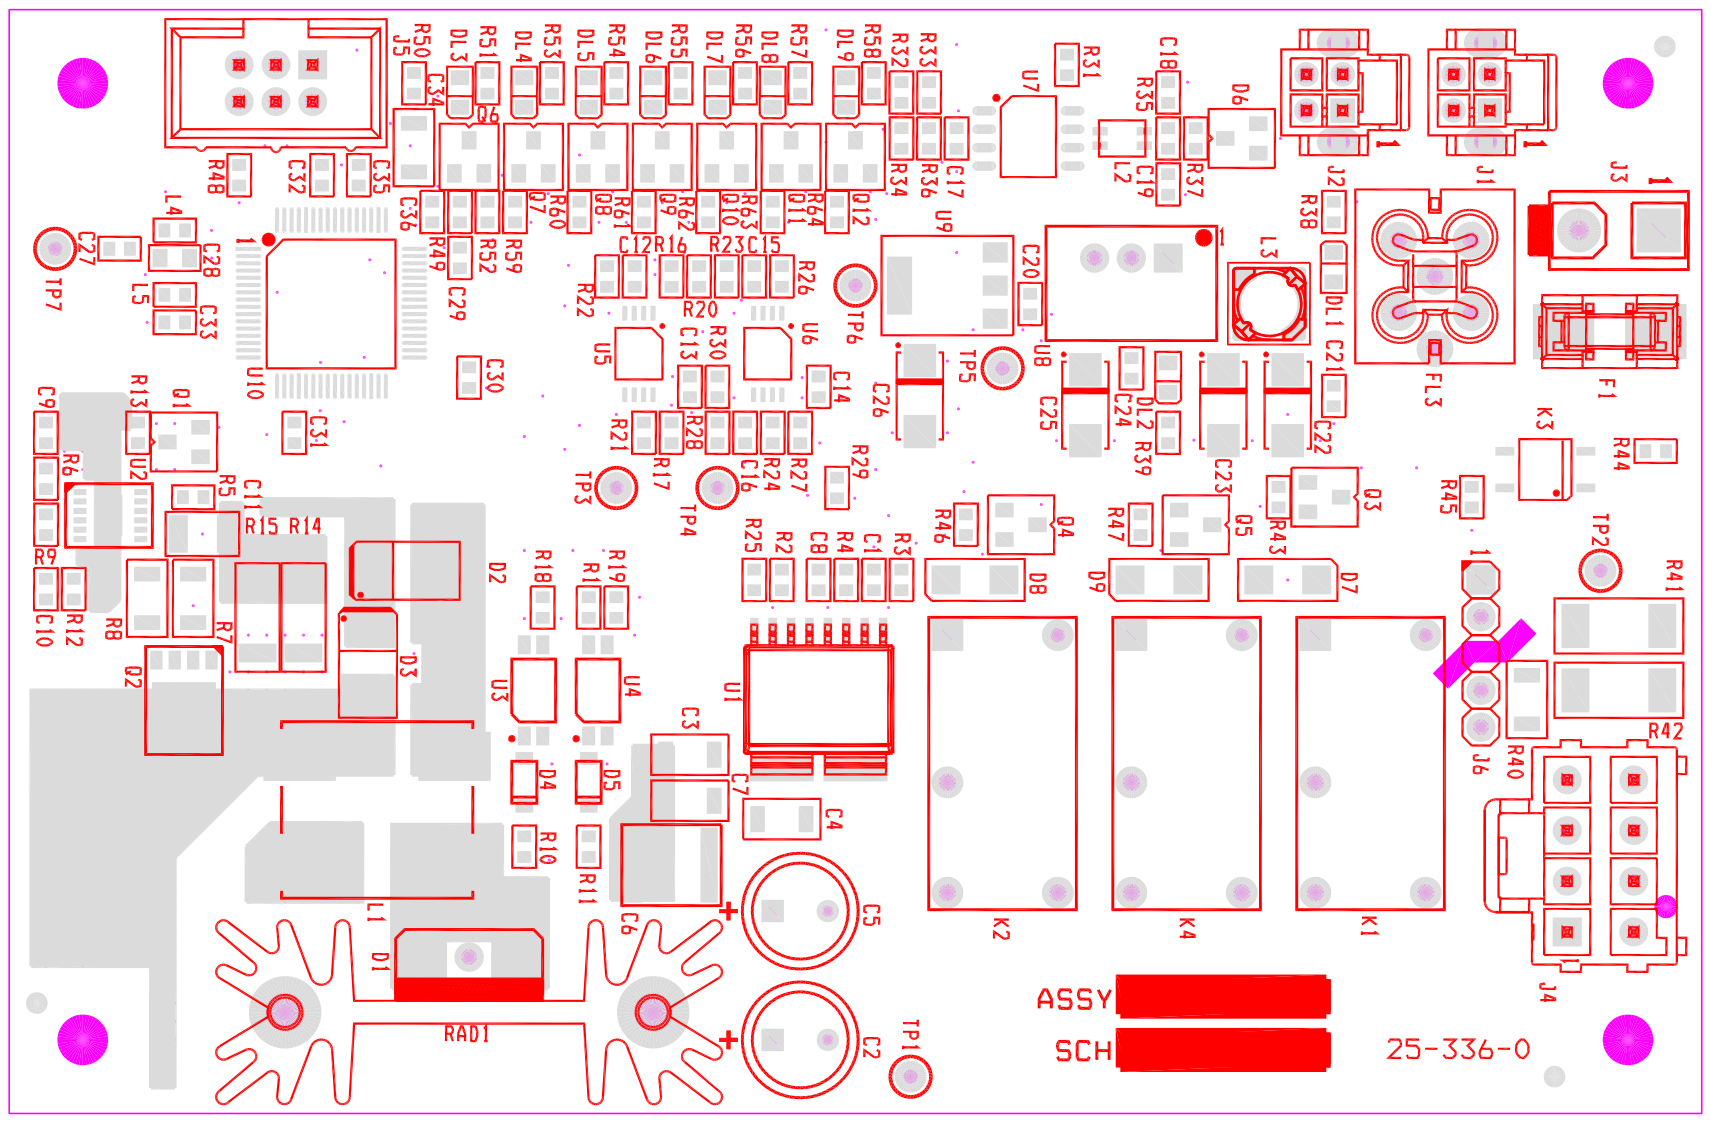
[picture p27: page 1]
