marcorispoli/PCB336/KiCad/ESECUTIVI/GRAFICA/TOP.pdf

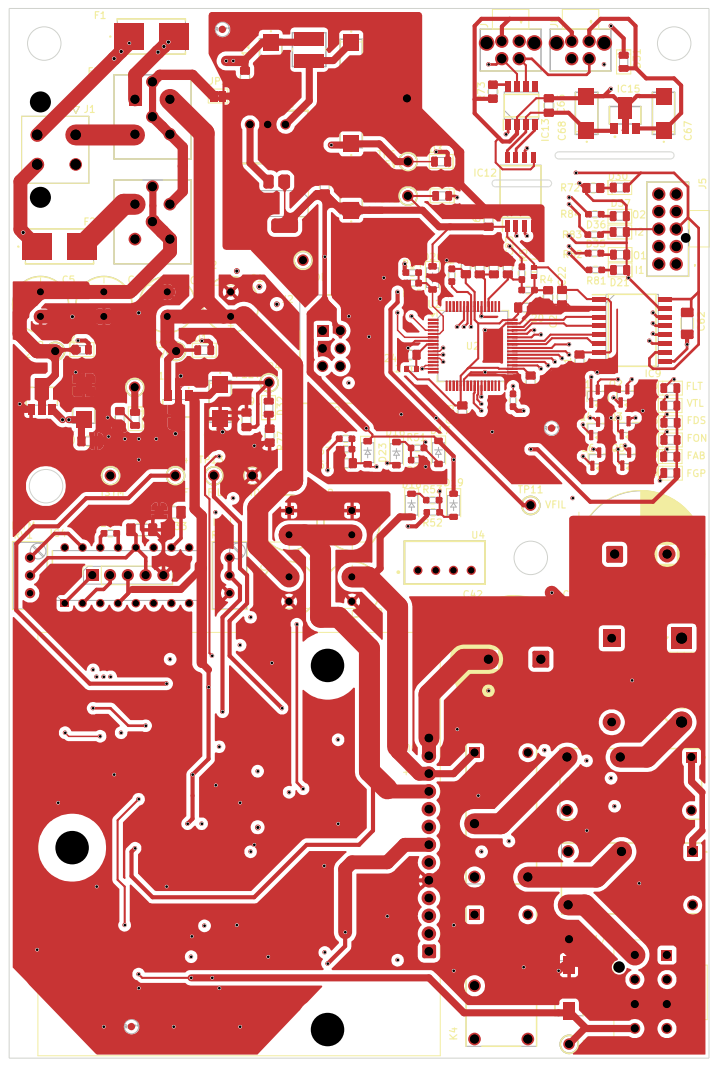
[picture p28: page 1]
