marcorispoli/PCB336/(list of files, drawings)

Other design files:
OLD/ORCAD/25-336-0.DSN
ORCAD/25-336-0.DSN
ORCAD/25-336-0.opj
ORCAD/LIBRARY.OLB
