marcorispoli/PCB336/KiCad/PCB336/PCB336.kicad_pcb

## KiCad design KiCad/PCB336/PCB336.kicad_pcb (2026-08-05)

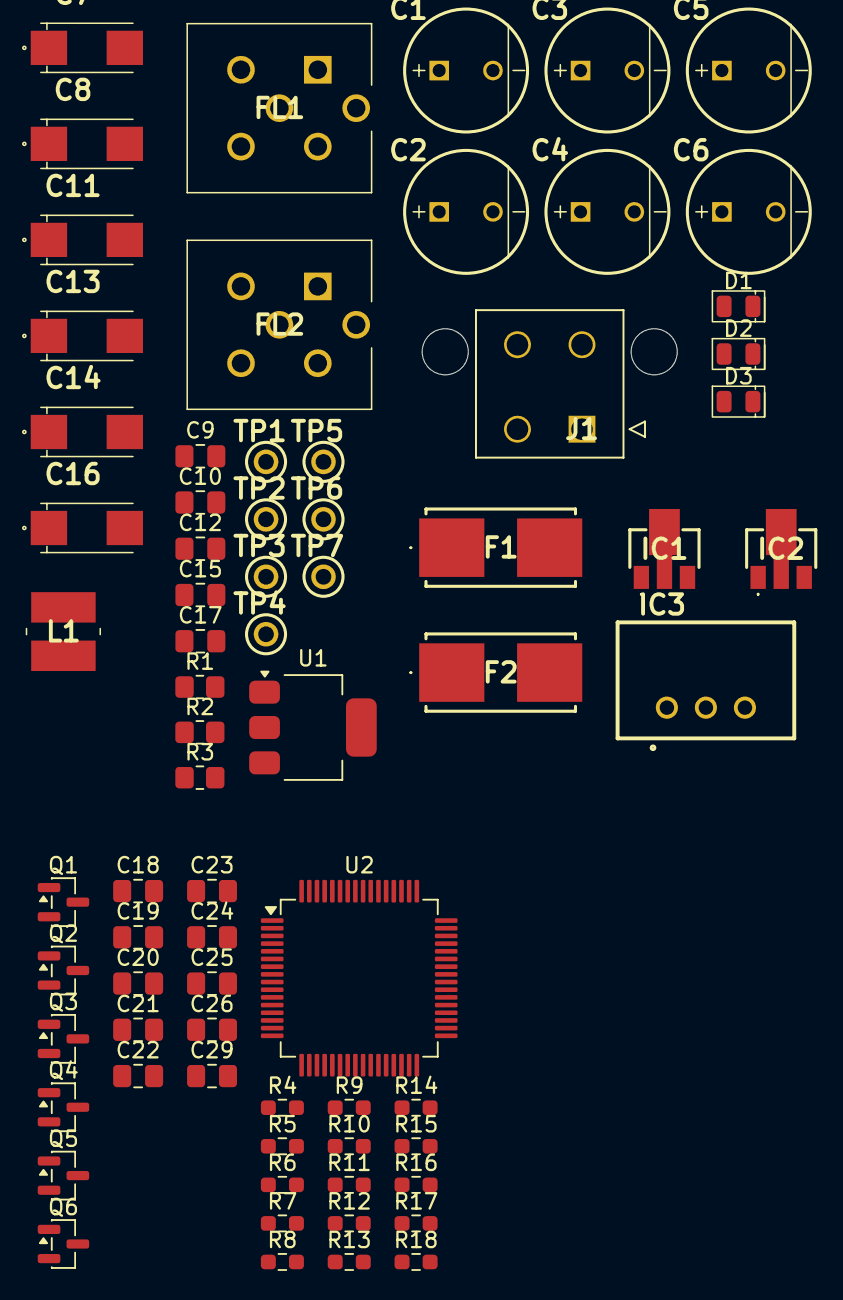
[picture p53: board KiCad/PCB336/PCB336.kicad_pcb from above]

Board: 2 copper layers, 72 parts (0 on the bottom side), 30 nets, no tracks yet.

Parts:
C1, C2, C3, C4, C5, C6: 33uF; WCAP-HTG5_D8_H9_P3.5
C7, C8, C11, C13, C14, C16: 4.7uF; T491C
C9, C10, C12, C15, C17, C18, C19, C20, C21, C22, C23, C24, C25: 100nF; C_0805_2012Metric_Pad1.18x1.45mm_HandSolder
C26: 4u7; C_0805_2012Metric_Pad1.18x1.45mm_HandSolder
C29: 10uF; C_0805_2012Metric_Pad1.18x1.45mm_HandSolder
D1, D2, D3: GREEN; LED_0805
F1, F2: 0154003.DRT; Littlefuse_serie_0154
FL1, FL2: BNX012-01; BNX01201
IC1: NJM78L12UA-TE1; NJM78L12UATE1
IC2: NJM79L12SU3-TE1
IC3: TSR_0.5-2450; TSR-0.5-2433
J1: 39-29-9043; 39-29-904Y
L1: SRR4828A-8R2Y; SRR4828A120M
Q1, Q2, Q3, Q4, Q5, Q6: 2N7002LT1G; SOT-23
R1, R2: 4K7; R_0805_2012Metric_Pad1.20x1.40mm_HandSolder
R3: 1K; R_0805_2012Metric_Pad1.20x1.40mm_HandSolder
R4: 10K; R_0603_1608Metric_Pad0.98x0.95mm_HandSolder
R5: 330R; R_0603_1608Metric_Pad0.98x0.95mm_HandSolder
R6: 1K; R_0603_1608Metric_Pad0.98x0.95mm_HandSolder
R7, R10, R12, R14, R16, R18: 680R; R_0603_1608Metric_Pad0.98x0.95mm_HandSolder
R8, R9, R11, R13, R15, R17: 33K; R_0603_1608Metric_Pad0.98x0.95mm_HandSolder
TP1, TP2, TP4, TP5, TP6, TP7: RED; TP_5001
TP3: BLACK; TP_5001
U1: NCP1117ST33T3G; SOT-223-3_TabPin2
U2: ATSAME51J20A-A; TQFP-64_10x10mm_P0.5mm

Connections:
+3V3: C16.1 (+), C17.1, C22.1, TP7.1 (1_1), U1.2 (VO)
+5V: C14.1 (+), C15.1, D3.2 (A), IC3.3 (+VOUT), R7.1, R10.1, R12.1, R14.1, R16.1, R18.1, TP6.1 (1_1), U1.3 (VI)
+12V: C7.1 (+), C9.1, IC1.1 (OUT), TP4.1 (1_1)
+24V: C1.1, C2.1, C3.1, C11.1 (+), C12.1, D1.2 (A), FL1.2 (OUTPUT), IC1.3 (IN), L1.1, TP1.1 (1_1)
-12V: C8.2 (-), C10.2, IC2.3 (OUT), TP5.1 (1_1)
-24V: C4.2, C5.2, C6.2, D2.1 (K), FL2.4 (GND_OUT1), FL2.5 (GND_OUT2), FL2.6 (GND_OUT3), IC2.2 (IN), TP2.1 (1_1)
/POWER/+B1: F1.1, J1.1
/POWER/+B2: F2.1, J1.3
/POWER/-B1: FL1.3 (GND_INPUT), J1.2
/POWER/-B2: FL2.3 (GND_INPUT), J1.4
/uController/LED1: Q3.1 (G), R11.1, U2.49 (PB22)
/uController/LED2: Q4.1 (G), R13.1, U2.40 (PB17)
/uController/LED3: Q5.1 (G), R15.1, U2.39 (PB16)
/uController/LED4: Q6.1 (G), R17.1, U2.24 (PB11)
/uController/LED_FLT: Q2.1 (G), R9.1, U2.50 (PB23)
/uController/LED_VTL: Q1.1 (G), R8.1, U2.60 (PB31)
/uController/SWCLK: R6.2, U2.57 (PA30)
/uController/Vuc: C18.2, C19.2, C20.1, C21.1, C29.2, R4.2, R6.1, U2.21 (VDDIOB), U2.34 (VDDIO), U2.48 (VDDIO), U2.56 (VDDIO)
/uController/uC_FILFREQ: U2.14 (PA05), U2.15 (PA06)
GND: C7.2 (-), C8.1 (+), C9.2, C10.1, C11.2 (-), C12.2, C13.2 (-), C14.2 (-), C15.2, C16.2 (-), C17.2, C18.1, C19.1, C20.2, C21.2, C22.2, C23.2, C24.1, C25.1, C26.1, C29.1, IC1.2 (GND), IC2.1 (GND), IC3.2 (GND), Q1.2 (S), Q2.2 (S), Q3.2 (S), Q4.2 (S), Q5.2 (S), Q6.2 (S), R1.2, R2.2, R3.2, R8.2, R9.2, R11.2, R13.2, R15.2, R17.2, TP3.1 (1_1), U1.1 (GND), U2.7 (GNDANA), U2.22 (GND), U2.33 (GND), U2.47 (GND), U2.54 (GND)
GND1: C1.2, C2.2, C3.2, C4.1, C5.1, C6.1, FL1.4 (GND_OUT1), FL1.5 (GND_OUT2), FL1.6 (GND_OUT3), FL2.2 (OUTPUT)
unnamed: C13.1 (+), IC3.1 (+VIN), L1.2
unnamed: D1.1 (K), R1.1
unnamed: D2.2 (A), R2.1
unnamed: D3.1 (K), R3.1
unnamed: F1.2, FL1.1 (INPUT)
unnamed: F2.2, FL2.1 (INPUT)
unnamed: C24.2, U2.8 (VDDANA)
unnamed: C25.2, C26.2, U2.53 (VDDCORE)
unnamed: C23.1, R4.1, R5.2, U2.52 (~RESET)
