marcorispoli/PCB336/KiCad/PCB336.kicad_pcb

## KiCad design KiCad/PCB336.kicad_pcb (2026-09-14)

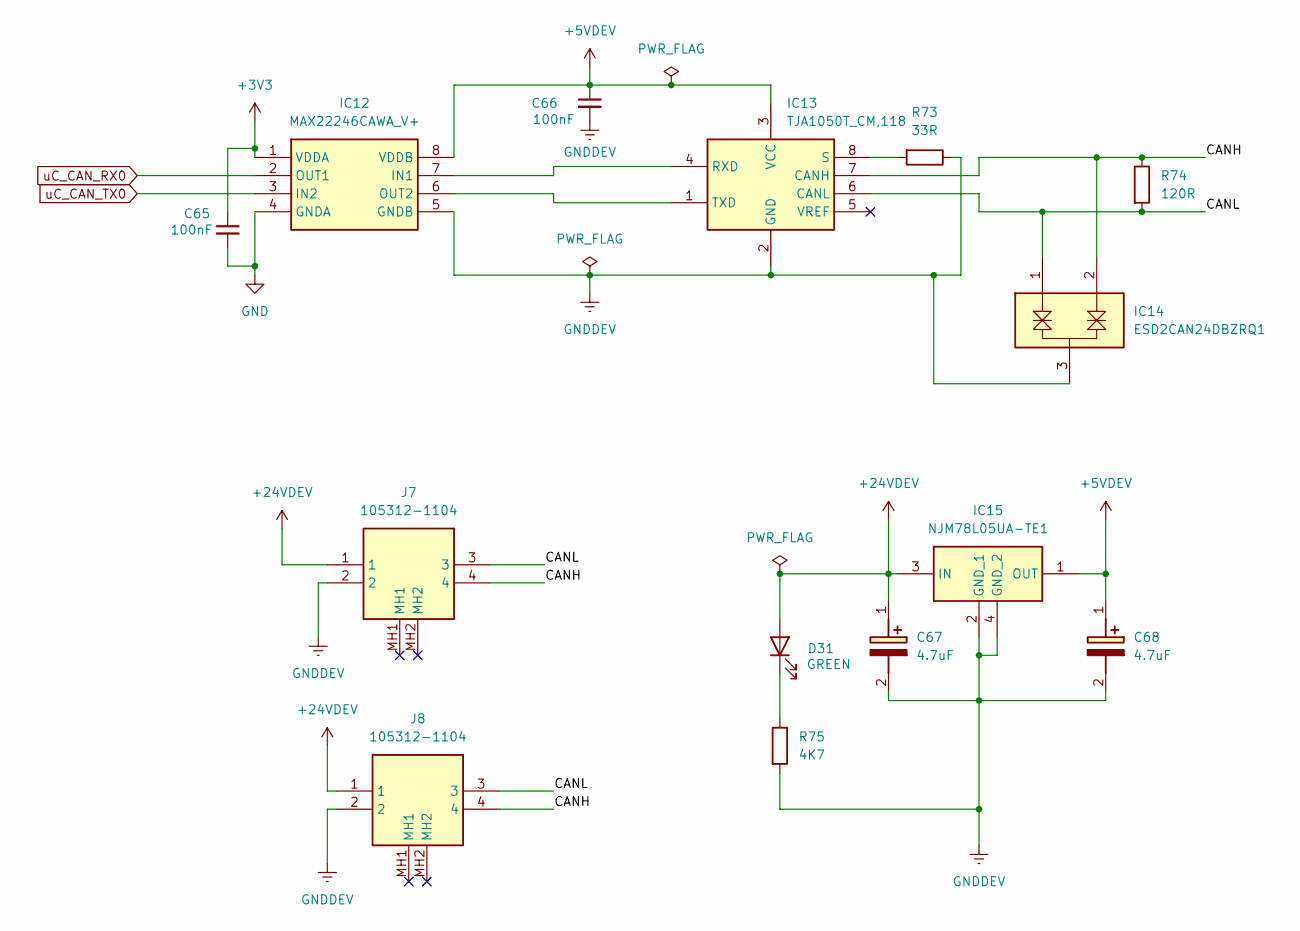
[picture p54: schematic can_bus.kicad_sch, PCB/25-336-1]

Parts:
C65, C66: 100nF; C_0805_2012Metric_Pad1.18x1.45mm_HandSolder
C67, C68: 4.7uF; T491C; Mouser Part Number 80-T491C475K035
D31: GREEN; LED_0805
IC12: MAX22246CAWA_V+; MAX22246_SOIC127P1031X265-8N; Mouser Part Number 700-MAX22246CAWA/V+
IC13: TJA1050T_CM,118; TJA1050T_SOIC127P600X175-8N; Mouser Part Number 771-TJA1050T/CM118
IC14: ESD2CAN24DBZRQ1; Mouser Part Number 595-ESD2CAN24DBZRQ1
IC15: NJM78L05UA-TE1; Mouser Part Number 513-NJM78L05UA-TE1
J7, J8: 105312-1104; NANOFIT_1053121104; Mouser Part Number 538-105312-1104
R73: 33R; R_0805_2012Metric_Pad1.20x1.40mm_HandSolder
R74: 120R; R_0603_1608Metric_Pad0.98x0.95mm_HandSolder
R75: 4K7; R_0805_2012Metric_Pad1.20x1.40mm_HandSolder

Connections:
+3V3: C65.1, IC12.1 (VDDA); also elsewhere on the board
+5VDEV: C66.1, C68.1 (+), IC12.8 (VDDB), IC13.3 (VCC), IC15.1 (OUT)
+24VDEV: C67.1 (+), D31.2 (A), IC15.3 (IN), J7.1, J8.1
/CAN BUS/CANH: IC13.7 (CANH), IC14.2 (I2), J7.4, J8.4, R74.1
/CAN BUS/CANL: IC13.6 (CANL), IC14.1 (I1), J7.3, J8.3, R74.2
GND: C65.2, IC12.4 (GNDA); also elsewhere on the board
GNDDEV: C66.2, C67.2 (-), C68.2 (-), IC12.5 (GNDB), IC13.2 (GND), IC14.3 (G), IC15.2 (GND_1), IC15.4 (GND_2), J7.2, J8.2, R73.1, R75.2
unnamed: D31.1 (K), R75.1
unnamed: IC12.7 (IN1), IC13.4 (RXD)
unnamed: IC12.6 (OUT2), IC13.1 (TXD)
unnamed: IC13.8 (S), R73.2
uC_CAN_RX0: IC12.2 (OUT1); also elsewhere on the board
uC_CAN_TX0: IC12.3 (IN2); also elsewhere on the board

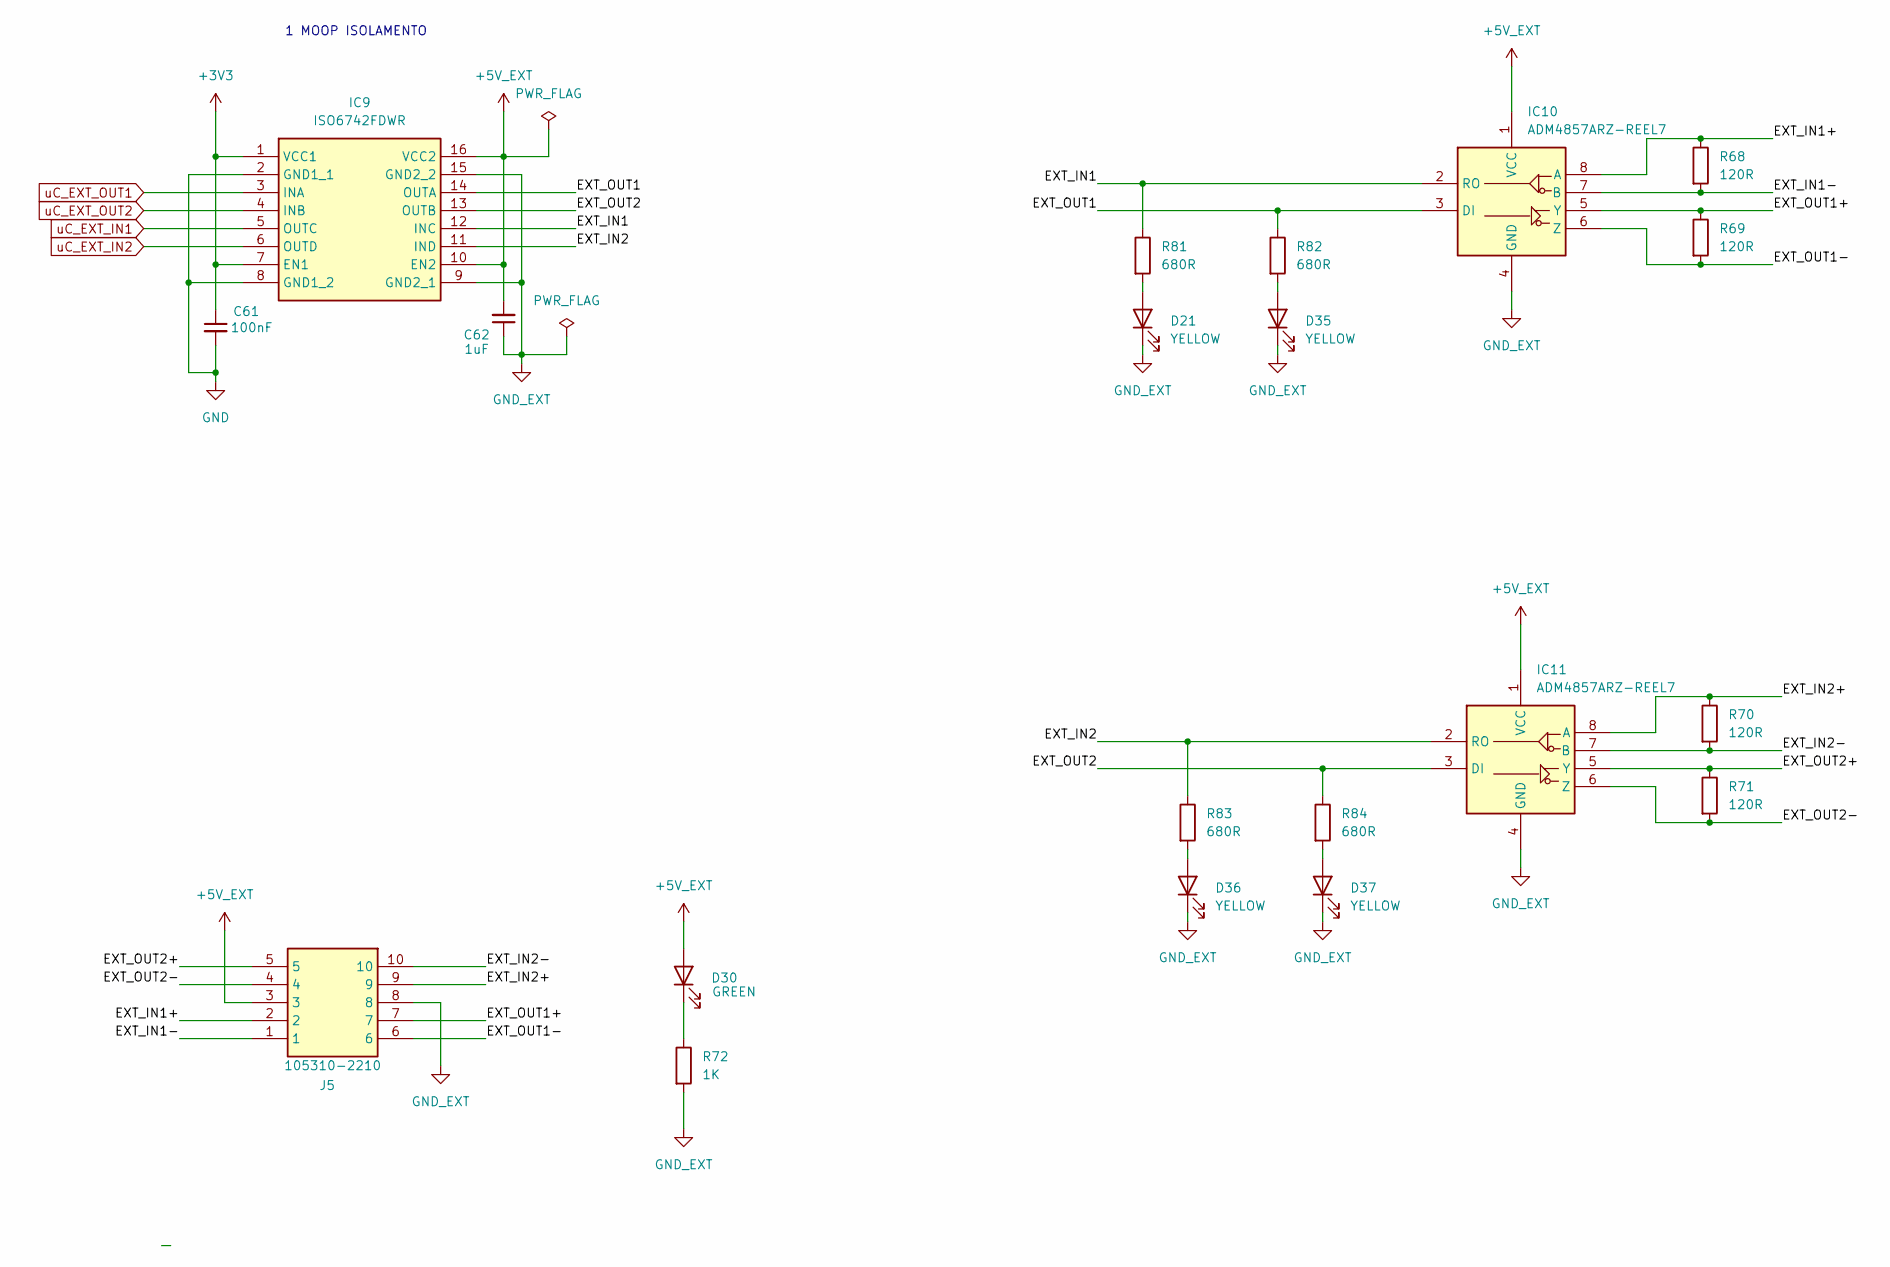
[picture p55: schematic externalsynch.kicad_sch, PCB/25-336-1]

Parts:
C61: 100nF; C_0805_2012Metric_Pad1.18x1.45mm_HandSolder
C62: 1uF; C_1206_3216Metric_Pad1.33x1.80mm_HandSolder; MOUSER 581-KAF31NR71C105JU
D21, D35, D36, D37: YELLOW; LED_0805
D30: GREEN; LED_0805
IC9: ISO6742FDWR; ISO6742FDWR_SOIC; Mouser Part Number 595-ISO6742FDWR
IC10, IC11: ADM4857ARZ-REEL7; ADM4857_SOIC; Mouser Part Number 584-ADM4857ARZ-R7
J5: 105310-2210; 1053102210; Mouser Part Number 538-105310-2210
R68, R69, R70, R71: 120R; R_0603_1608Metric_Pad0.98x0.95mm_HandSolder
R72: 1K; R_0805_2012Metric_Pad1.20x1.40mm_HandSolder
R81, R82, R83, R84: 680R; R_0603_1608Metric_Pad0.98x0.95mm_HandSolder

Connections:
+3V3: C61.1, IC9.1 (VCC1), IC9.7 (EN1); also elsewhere on the board
+5V_EXT: C62.2, D30.2 (A), IC9.10 (EN2), IC9.16 (VCC2), IC10.1 (VCC), IC11.1 (VCC), J5.3
/ExternalSynch/EXT_IN1: IC9.12 (INC), IC10.2 (RO), R81.1
/ExternalSynch/EXT_IN1+: IC10.8 (A), J5.2, R68.1
/ExternalSynch/EXT_IN1-: IC10.7 (B), J5.1, R68.2
/ExternalSynch/EXT_IN2: IC9.11 (IND), IC11.2 (RO), R83.1
/ExternalSynch/EXT_IN2+: IC11.8 (A), J5.9, R70.1
/ExternalSynch/EXT_IN2-: IC11.7 (B), J5.10, R70.2
/ExternalSynch/EXT_OUT1: IC9.14 (OUTA), IC10.3 (DI), R82.1
/ExternalSynch/EXT_OUT1+: IC10.5 (Y), J5.7, R69.1
/ExternalSynch/EXT_OUT1-: IC10.6 (Z), J5.6, R69.2
/ExternalSynch/EXT_OUT2: IC9.13 (OUTB), IC11.3 (DI), R84.1
/ExternalSynch/EXT_OUT2+: IC11.5 (Y), J5.5, R71.1
/ExternalSynch/EXT_OUT2-: IC11.6 (Z), J5.4, R71.2
GND: C61.2, IC9.2 (GND1_1), IC9.8 (GND1_2); also elsewhere on the board
GND_EXT: C62.1, D21.1 (K), D35.1 (K), D36.1 (K), D37.1 (K), IC9.9 (GND2_1), IC9.15 (GND2_2), IC10.4 (GND), IC11.4 (GND), J5.8, R72.2
unnamed: D21.2 (A), R81.2
unnamed: D30.1 (K), R72.1
unnamed: D35.2 (A), R82.2
unnamed: D36.2 (A), R83.2
unnamed: D37.2 (A), R84.2
uC_EXT_IN1: IC9.5 (OUTC); also elsewhere on the board
uC_EXT_IN2: IC9.6 (OUTD); also elsewhere on the board
uC_EXT_OUT1: IC9.3 (INA); also elsewhere on the board
uC_EXT_OUT2: IC9.4 (INB); also elsewhere on the board

Notes on the sheet:
1 MOOP ISOLAMENTO

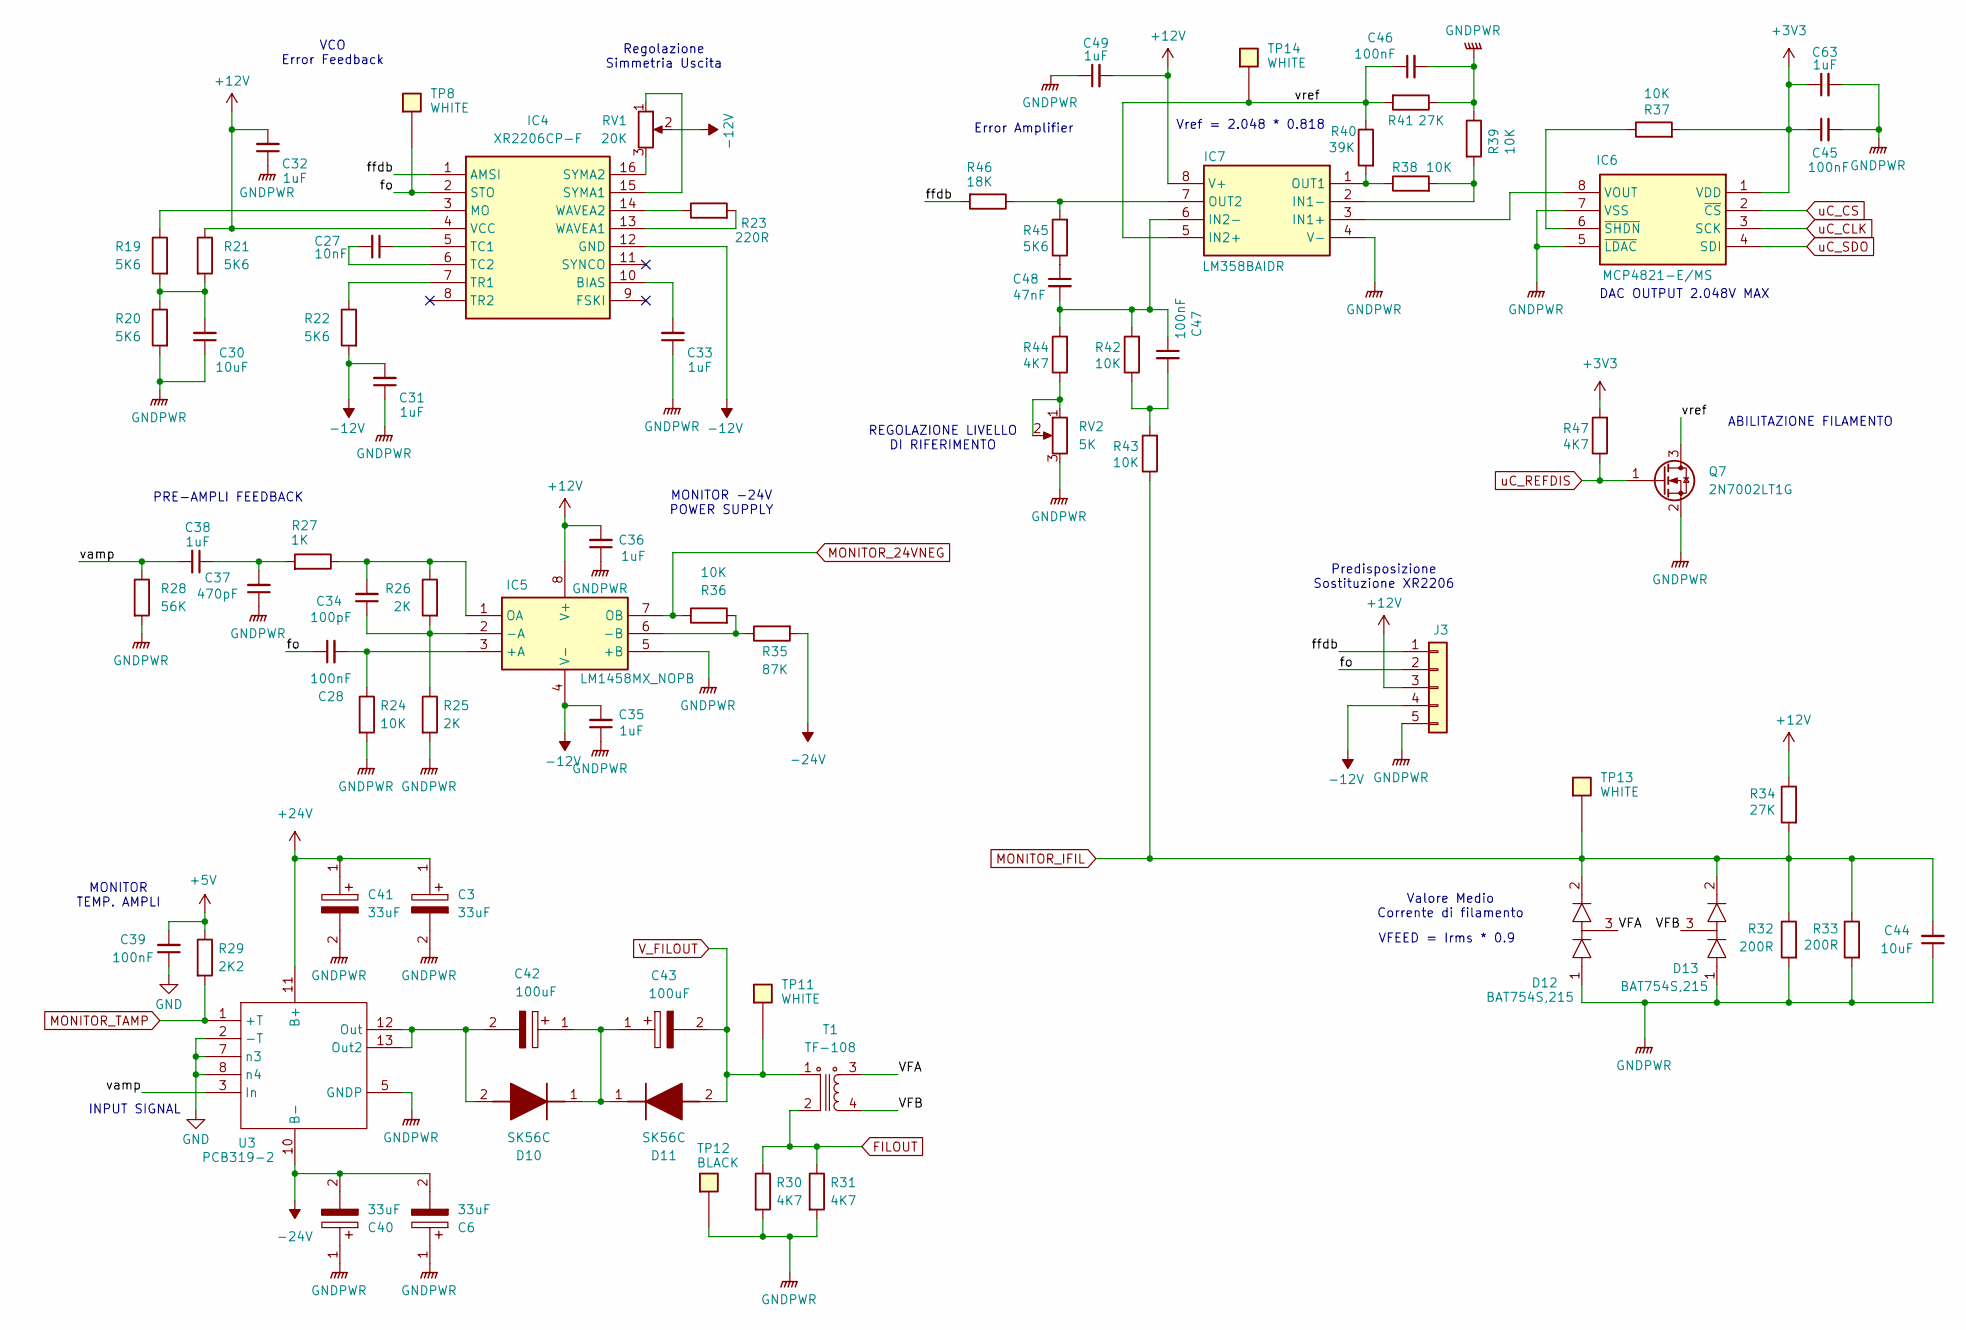
[picture p56: schematic filamentcontrol.kicad_sch, PCB/25-336-1]

Parts:
C3, C6, C40, C41: 33uF; WCAP-HTG5_D8_H9_P3.5; Mouser Part Number 710-870575774002
C27: 10nF; C_0805_2012Metric_Pad1.18x1.45mm_HandSolder
C28, C39, C45, C46, C47: 100nF; C_0805_2012Metric_Pad1.18x1.45mm_HandSolder
C30, C44: 10uF; C_1206_3216Metric_Pad1.33x1.80mm_HandSolder
C31, C32, C33, C35, C36, C38, C49, C63: 1uF; C_1206_3216Metric_Pad1.33x1.80mm_HandSolder; MOUSER 581-KAF31NR71C105JU
C34: 100pF; C_0603_1608Metric_Pad1.08x0.95mm_HandSolder
C37: 470pF; C_0603_1608Metric_Pad1.08x0.95mm_HandSolder
C42, C43: 100uF; CP_Radial_D18.0mm_P7.50mm; Mouser Part Number 667-EEU-EE2D101S
C48: 47nF; C_0805_2012Metric_Pad1.18x1.45mm_HandSolder
D10, D11: SK56C; Mouser Part Number 821-SK56C
D12, D13: BAT754S,215; Mouser Part Number 771-BAT754S-T/R
IC4: XR2206CP-F; XR2206CP; Mouser Part Number 701-XR2206CP-F
IC5: LM1458MX_NOPB; SOIC_LM1458M; Mouser Part Number 926-LM1458MX/NOPB
IC6: MCP4821-E/MS; MCP4821_EMS; Mouser Part Number 579-MCP4821-E/MS
IC7: LM358BAIDR; Mouser Part Number 595-LM358BAIDR
J3: Piazzolato; PinSocket_1x05_P2.54mm_Vertical
Q7: 2N7002LT1G; SOT-23; MOUSER 863-2N7002LT1G
R19, R20, R21, R22, R45: 5K6; R_0603_1608Metric_Pad0.98x0.95mm_HandSolder
R23: 220R; R_0603_1608Metric_Pad0.98x0.95mm_HandSolder
R24, R36, R37, R38, R39, R42, R43: 10K; R_0603_1608Metric_Pad0.98x0.95mm_HandSolder
R25, R26: 2K; R_0603_1608Metric_Pad0.98x0.95mm_HandSolder
R27: 1K; R_0603_1608Metric_Pad0.98x0.95mm_HandSolder
R28: 56K; R_0603_1608Metric_Pad0.98x0.95mm_HandSolder
R29: 2K2; R_0603_1608Metric_Pad0.98x0.95mm_HandSolder
R30, R31: 4K7; R_1206_3216Metric_Pad1.30x1.75mm_HandSolder
R32, R33: 200R; R_0603_1608Metric_Pad0.98x0.95mm_HandSolder
R34, R41: 27K; R_0603_1608Metric_Pad0.98x0.95mm_HandSolder
R35: 87K; R_0603_1608Metric_Pad0.98x0.95mm_HandSolder
R40: 39K; R_0603_1608Metric_Pad0.98x0.95mm_HandSolder
R44, R47: 4K7; R_0603_1608Metric_Pad0.98x0.95mm_HandSolder
R46: 18K; R_0603_1608Metric_Pad0.98x0.95mm_HandSolder
RV1: 20K; Potentiometer_Bourns_3296W_Vertical
RV2: 5K; Potentiometer_Bourns_3296W_Vertical
T1: TF-108
TP8, TP11, TP13, TP14: 5002; TP_5001; Mouser Part Number 534-5001
TP12: 5001; TP_5001; Mouser Part Number 534-5001
U3: PCB319-2

Connections:
+3V3: C45.1, C63.1, IC6.1 (VDD), R37.2, R47.2; also elsewhere on the board
+5V: C39.2, R29.1; also elsewhere on the board
+12V: C32.2, C36.2, C49.2, IC4.4 (VCC), IC5.8 (V+), IC7.8 (V+), J3.3, R21.1, R34.1; also elsewhere on the board
+24V: C3.1, C41.1, U3.11 (B+); also elsewhere on the board
-12V: C31.2, C35.2, IC4.12 (GND), IC5.4 (V-), J3.4, R22.2, RV1.2; also elsewhere on the board
-24V: C6.2, C40.2, R35.2, U3.10 (B-); also elsewhere on the board
/FilamentControl/VFA: D12.3 (COM), T1.3 (O1)
/FilamentControl/VFB: D13.3 (COM), T1.4 (O2)
/FilamentControl/ffdb: IC4.1 (AMSI), J3.1, R46.2
/FilamentControl/fo: C28.1, IC4.2 (STO), J3.2, TP8.1 (1_1)
/FilamentControl/vamp: C38.2, R28.1, U3.3 (In)
/FilamentControl/vref: C46.1, IC7.5 (IN2+), Q7.3 (D), R40.1, R41.2, TP14.1 (1_1)
FILOUT: R30.1, R31.1, T1.2; also elsewhere on the board
GND: C39.1, U3.2 (-T), U3.7 (n3), U3.8 (n4); also elsewhere on the board
GNDPWR: C3.2, C6.1, C30.1, C31.1, C32.1, C33.1, C35.1, C36.1, C37.1, C40.1, C41.2, C44.1, C45.2, C46.2, C49.1, C63.2, D12.1 (A), D13.1 (A), IC5.5 (+B), IC6.5 (~LDAC), IC6.7 (VSS), IC7.4 (V-), J3.5, Q7.2 (S), R20.2, R24.2, R25.2, R28.2, R30.2, R31.2, R32.2, R33.2, R39.1, R41.1, RV2.3, TP12.1 (1_1), U3.5 (GNDP); also elsewhere on the board
MONITOR_24VNEG: IC5.7 (OB), R36.1; also elsewhere on the board
MONITOR_IFIL: C44.2, D12.2 (K), D13.2 (K), R32.1, R33.1, R34.2, R43.1, TP13.1 (1_1); also elsewhere on the board
MONITOR_TAMP: R29.2, U3.1 (+T); also elsewhere on the board
unnamed: C30.2, R19.2, R20.1, R21.2
unnamed: C37.2, C38.1, R27.2
unnamed: C47.2, R42.1, R43.2
unnamed: C48.1, R45.1
unnamed: C42.2, D10.2 (A), U3.12 (Out), U3.13 (Out2)
unnamed: C42.1, C43.1, D10.1 (K), D11.1 (K)
unnamed: C33.2, IC4.10 (BIAS)
unnamed: IC4.3 (MO), R19.1
unnamed: IC4.15 (SYMA1), RV1.1
unnamed: IC4.16 (SYMA2), RV1.3
unnamed: C27.1, IC4.5 (TC1)
unnamed: C27.2, IC4.6 (TC2)
unnamed: IC4.7 (TR1), R22.1
unnamed: IC4.13 (WAVEA1), R23.2
unnamed: IC4.14 (WAVEA2), R23.1
unnamed: C28.2, IC5.3 (+A), R24.1
unnamed: C34.1, IC5.2 (-A), R25.1, R26.2
unnamed: IC5.6 (-B), R35.1, R36.2
unnamed: C34.2, IC5.1 (OA), R26.1, R27.1
unnamed: IC6.8 (VOUT), IC7.3 (IN1+)
unnamed: IC6.6 (~SHDN), R37.1
unnamed: IC7.2 (IN1-), R38.2, R39.2
unnamed: C47.1, C48.2, IC7.6 (IN2-), R42.2, R44.2
unnamed: IC7.1 (OUT1), R38.1, R40.2
unnamed: IC7.7 (OUT2), R45.2, R46.1
unnamed: R44.1, RV2.1, RV2.2
V_FILOUT: C43.2, D11.2 (A), T1.1, TP11.1 (1_1); also elsewhere on the board
uC_CLK: IC6.3 (SCK); also elsewhere on the board
uC_CS: IC6.2 (~CS); also elsewhere on the board
uC_REFDIS: Q7.1 (G), R47.1; also elsewhere on the board
uC_SDO: IC6.4 (SDI); also elsewhere on the board

Notes on the sheet:
VCO Error Feedback
PRE-AMPLI FEEDBACK
Error Amplifier
Valore Medio Corrente di filamento
Vref = 2.048 * 0.818
ABILITAZIONE FILAMENTO
Predisposizione Sostituzione XR2206
VFEED = Irms * 0.9
INPUT SIGNAL
REGOLAZIONE LIVELLO DI RIFERIMENTO
Regolazione Simmetria Uscita
MONITOR -24V POWER SUPPLY
DAC OUTPUT 2.048V MAX
MONITOR TEMP. AMPLI

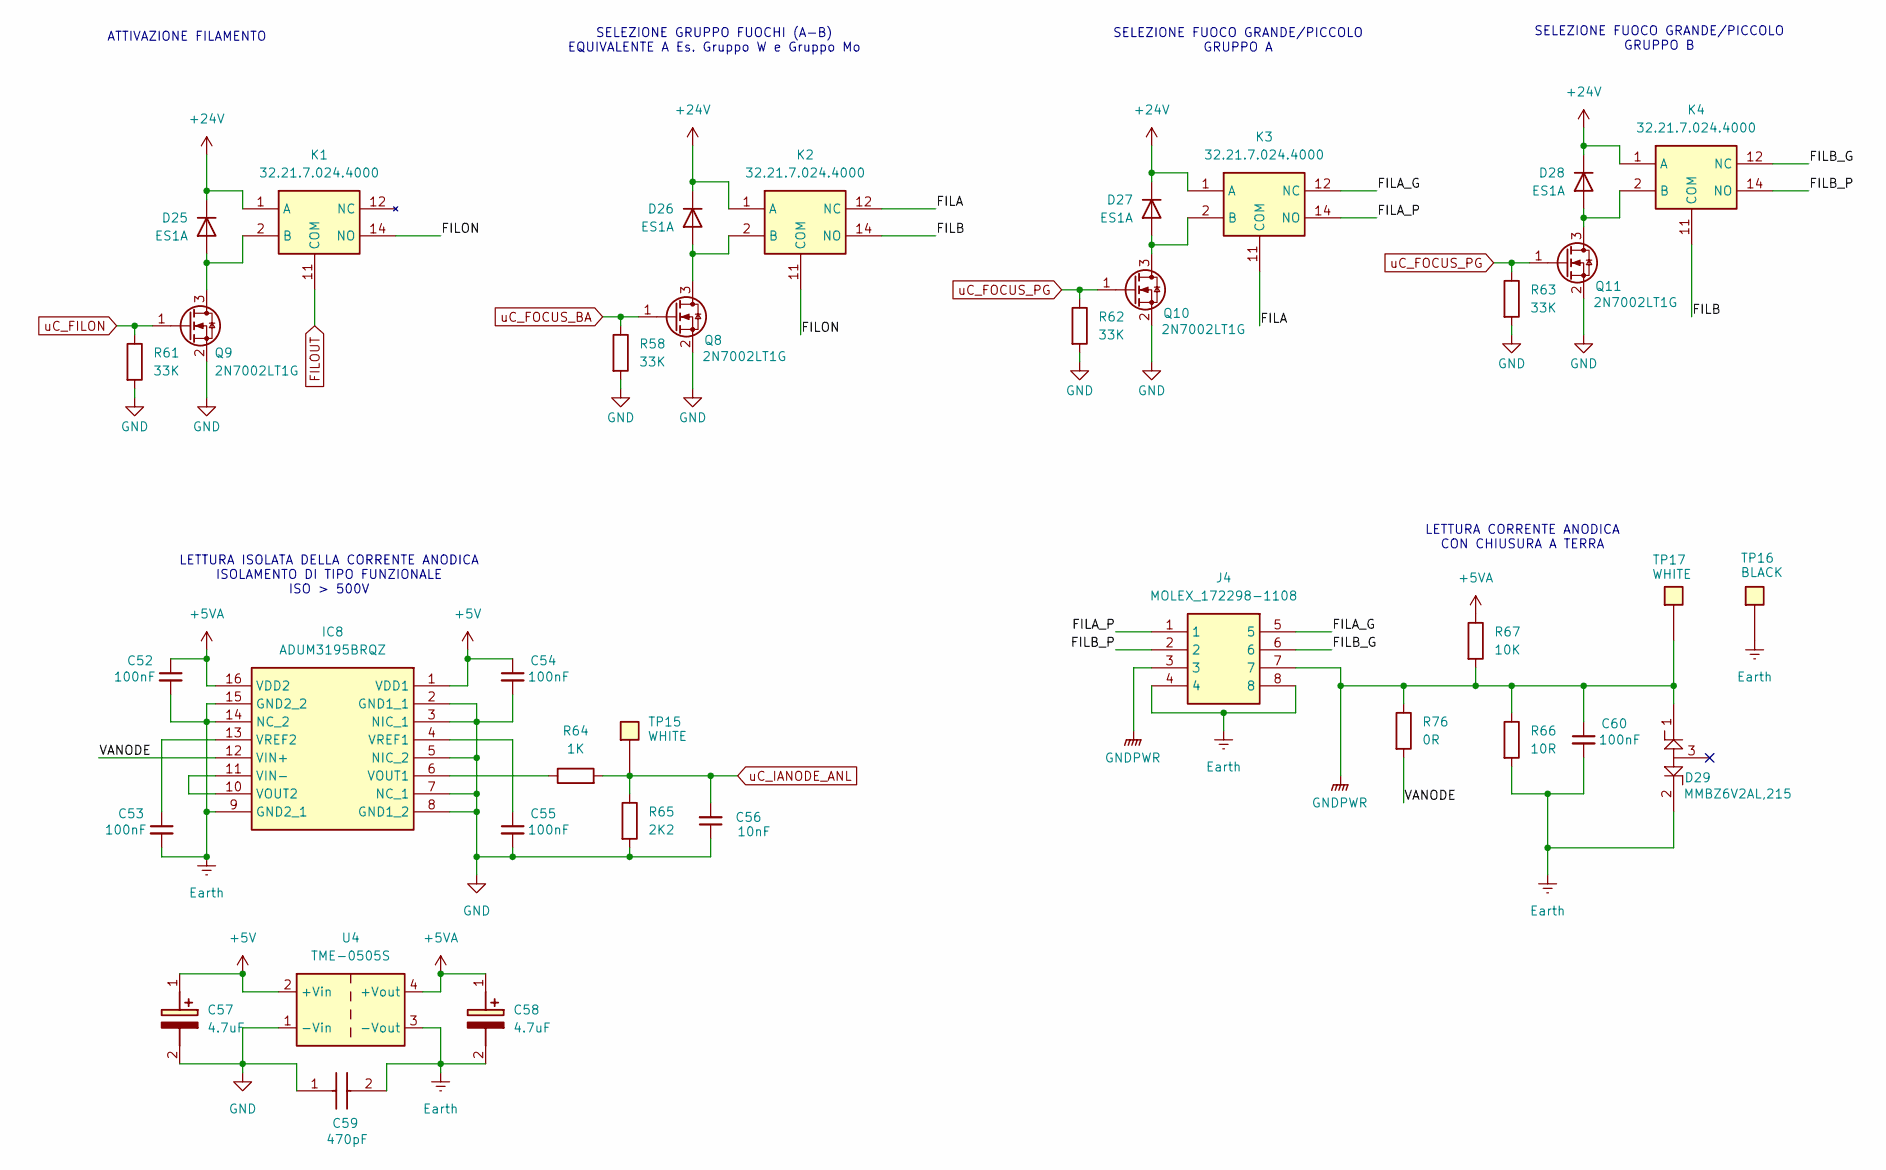
[picture p57: schematic load.kicad_sch, PCB/25-336-1]

Parts:
C52, C53, C54, C55, C60: 100nF; C_0805_2012Metric_Pad1.18x1.45mm_HandSolder
C56: 10nF; C_0805_2012Metric_Pad1.18x1.45mm_HandSolder
C57, C58: 4.7uF; T491C; Mouser Part Number 80-T491C475K035
C59: 470pF; C470pF_WURTH_APC4632X160N; Mouser Part Number 710-8853522110011
D25, D26, D27, D28: ES1A
D29: MMBZ6V2AL,215; Mouser Part Number 771-MMBZ6V2AL215
IC8: ADUM3195BRQZ; SOP64P599X175-16N; Mouser Part Number 584-ADUM3195BRQZ
J4: MOLEX_172298-1108; MOLEX_172298_1108; Mouser Part Number 538-172298-1108
K1, K2, K3, K4: 32.21.7.024.4000; 322170244000; Manufacturer_Part_Number 32.21.7.024.4000
Q8, Q9, Q10, Q11: 2N7002LT1G; SOT-23; MOUSER 863-2N7002LT1G
R58, R61, R62, R63: 33K; R_0603_1608Metric_Pad0.98x0.95mm_HandSolder
R64: 1K; R_0603_1608Metric_Pad0.98x0.95mm_HandSolder
R65: 2K2; R_0603_1608Metric_Pad0.98x0.95mm_HandSolder
R66: 10R; RES_10R_SMW210R
R67: 10K; R_0603_1608Metric_Pad0.98x0.95mm_HandSolder
R76: 0R; R_0603_1608Metric_Pad0.98x0.95mm_HandSolder
TP15, TP17: 5002; TP_5001; Mouser Part Number 534-5001
TP16: 5001; TP_5001; Mouser Part Number 534-5001
U4: TME-0505S

Connections:
+5V: C54.1, C57.1 (+), IC8.1 (VDD1), U4.2 (+Vin); also elsewhere on the board
+5VA: C52.1, C58.1 (+), IC8.16 (VDD2), R67.1, U4.4 (+Vout)
+24V: D25.1 (K), D26.1 (K), D27.1 (K), D28.1 (K), K1.1 (A), K2.1 (A), K3.1 (A), K4.1 (A); also elsewhere on the board
/Load/FILA: K2.12 (NC), K3.11 (COM)
/Load/FILA_G: J4.5, K3.12 (NC)
/Load/FILA_P: J4.1, K3.14 (NO)
/Load/FILB: K2.14 (NO), K4.11 (COM)
/Load/FILB_G: J4.6, K4.12 (NC)
/Load/FILB_P: J4.2, K4.14 (NO)
/Load/FILON: K1.14 (NO), K2.11 (COM)
/Load/VANODE: IC8.12 (VIN+), R76.2
Earth: C52.2, C53.2, C58.2 (-), C59.2, C60.2, D29.2 (CATHODE_(DIODE_2)), IC8.9 (GND2_1), IC8.14 (NC_2), IC8.15 (GND2_2), J4.4, J4.8, R66.2, TP16.1 (1_1), U4.3 (-Vout)
FILOUT: K1.11 (COM); also elsewhere on the board
GND: C54.2, C55.2, C56.1, C57.2 (-), C59.1, IC8.2 (GND1_1), IC8.3 (NIC_1), IC8.5 (NIC_2), IC8.7 (NC_1), IC8.8 (GND1_2), Q8.2 (S), Q9.2 (S), Q10.2 (S), Q11.2 (S), R58.2, R61.2, R62.2, R63.2, R65.2, U4.1 (-Vin); also elsewhere on the board
GNDPWR: C60.1, D29.1 (CATHODE_(DIODE_1)), J4.3, J4.7, R66.1, R67.2, R76.1, TP17.1 (1_1); also elsewhere on the board
unnamed: D25.2 (A), K1.2 (B), Q9.3 (D)
unnamed: D26.2 (A), K2.2 (B), Q8.3 (D)
unnamed: D27.2 (A), K3.2 (B), Q10.3 (D)
unnamed: D28.2 (A), K4.2 (B), Q11.3 (D)
unnamed: IC8.10 (VOUT2), IC8.11 (VIN-)
unnamed: IC8.6 (VOUT1), R64.1
unnamed: C55.1, IC8.4 (VREF1)
unnamed: C53.1, IC8.13 (VREF2)
uC_FILON: Q9.1 (G), R61.1; also elsewhere on the board
uC_FOCUS_BA: Q8.1 (G), R58.1; also elsewhere on the board
uC_FOCUS_PG: Q10.1 (G), Q11.1 (G), R62.1, R63.1; also elsewhere on the board
uC_IANODE_ANL: C56.2, R64.2, R65.1, TP15.1 (1_1); also elsewhere on the board

Notes on the sheet:
LETTURA CORRENTE ANODICA CON CHIUSURA A TERRA
LETTURA ISOLATA DELLA CORRENTE ANODICA ISOLAMENTO DI TIPO FUNZIONALE ISO > 500V
ATTIVAZIONE FILAMENTO
SELEZIONE FUOCO GRANDE/PICCOLO GRUPPO B
SELEZIONE GRUPPO FUOCHI (A-B) EQUIVALENTE A Es. Gruppo W e Gruppo Mo
SELEZIONE FUOCO GRANDE/PICCOLO GRUPPO A

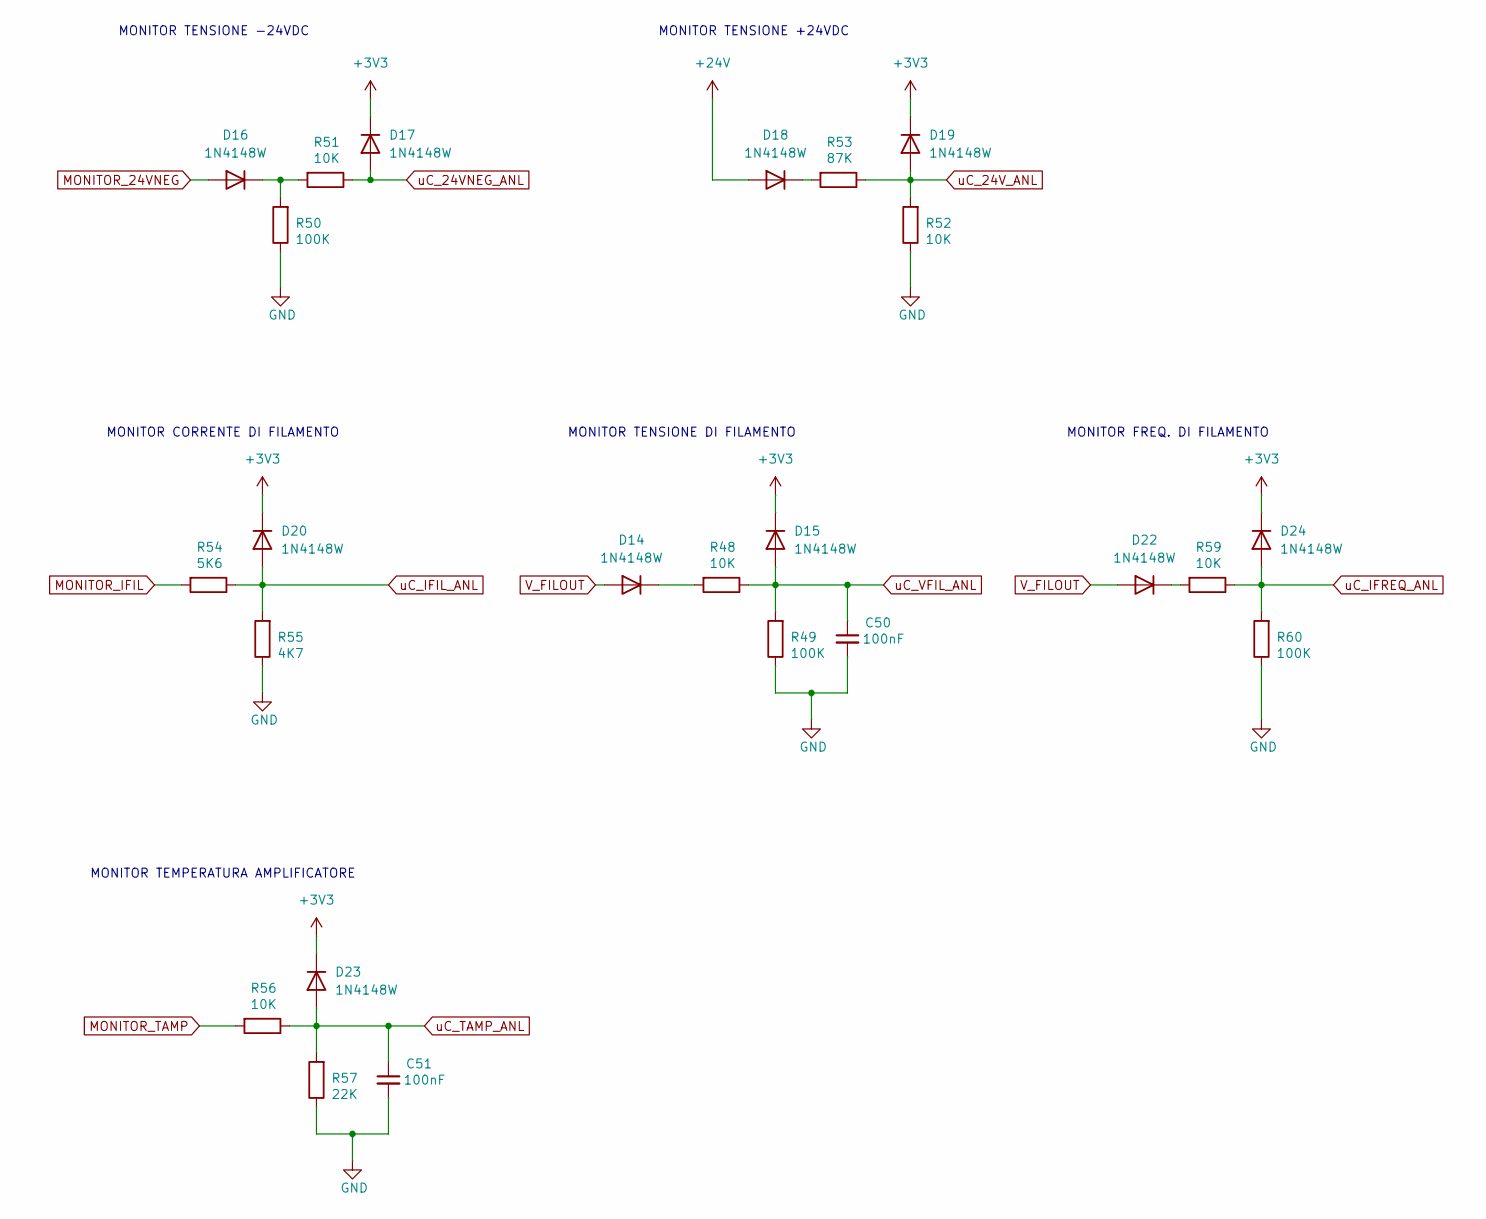
[picture p58: schematic monitor.kicad_sch, PCB/25-336-1]

Parts:
C50, C51: 100nF; C_0805_2012Metric_Pad1.18x1.45mm_HandSolder
D14, D15, D16, D17, D18, D19, D20, D22, D23, D24: 1N4148W; D_SOD-123
R48, R51, R52, R56, R59: 10K; R_0603_1608Metric_Pad0.98x0.95mm_HandSolder
R49, R50, R60: 100K; R_0603_1608Metric_Pad0.98x0.95mm_HandSolder
R53: 87K; R_0603_1608Metric_Pad0.98x0.95mm_HandSolder
R54: 5K6; R_0603_1608Metric_Pad0.98x0.95mm_HandSolder
R55: 4K7; R_0603_1608Metric_Pad0.98x0.95mm_HandSolder
R57: 22K; R_0603_1608Metric_Pad0.98x0.95mm_HandSolder

Connections:
+3V3: D15.1 (K), D17.1 (K), D19.1 (K), D20.1 (K), D23.1 (K), D24.1 (K); also elsewhere on the board
+24V: D18.2 (A); also elsewhere on the board
GND: C50.2, C51.2, R49.1, R50.1, R52.1, R55.1, R57.1, R60.1; also elsewhere on the board
MONITOR_24VNEG: D16.2 (A); also elsewhere on the board
MONITOR_IFIL: R54.2; also elsewhere on the board
MONITOR_TAMP: R56.2; also elsewhere on the board
unnamed: D14.1 (K), R48.2
unnamed: D16.1 (K), R50.2, R51.2
unnamed: D18.1 (K), R53.2
unnamed: D22.1 (K), R59.2
V_FILOUT: D14.2 (A), D22.2 (A); also elsewhere on the board
uC_24VNEG_ANL: D17.2 (A), R51.1; also elsewhere on the board
uC_24V_ANL: D19.2 (A), R52.2, R53.1; also elsewhere on the board
uC_IFIL_ANL: D20.2 (A), R54.1, R55.2; also elsewhere on the board
uC_IFREQ_ANL: D24.2 (A), R59.1, R60.2; also elsewhere on the board
uC_TAMP_ANL: C51.1, D23.2 (A), R56.1, R57.2; also elsewhere on the board
uC_VFIL_ANL: C50.1, D15.2 (A), R48.1, R49.2; also elsewhere on the board

Notes on the sheet:
MONITOR TENSIONE -24VDC
MONITOR TENSIONE +24VDC
MONITOR FREQ. DI FILAMENTO
MONITOR TEMPERATURA AMPLIFICATORE
MONITOR CORRENTE DI FILAMENTO
MONITOR TENSIONE DI FILAMENTO
