marcorispoli/PCB336/KiCad/PCB336.kicad_pcb

## KiCad design KiCad/PCB336.kicad_pcb (continued)

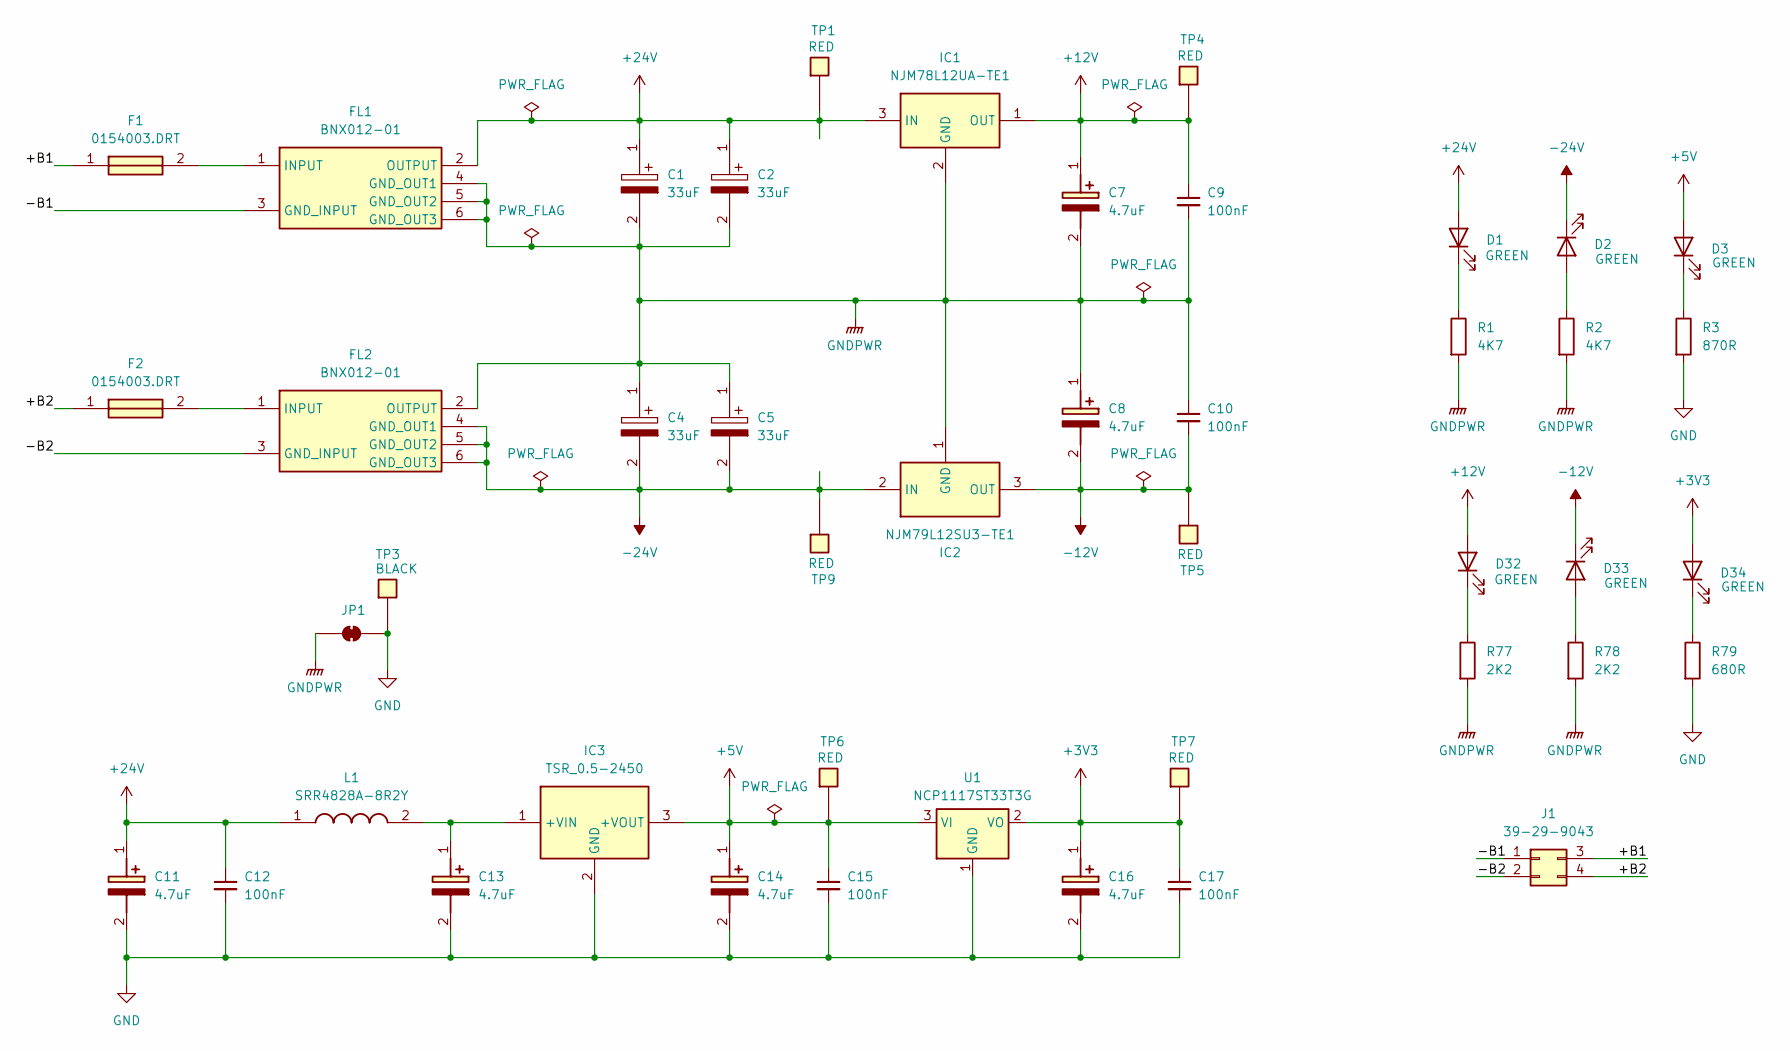
[picture p59: schematic power.kicad_sch, PCB/25-336-1]

Parts:
C1, C2, C4, C5: 33uF; WCAP-HTG5_D8_H9_P3.5; Mouser Part Number 710-870575774002
C7, C8, C11, C13, C14, C16: 4.7uF; T491C; Mouser Part Number 80-T491C475K035
C9, C10, C12, C15, C17: 100nF; C_0805_2012Metric_Pad1.18x1.45mm_HandSolder
D1, D2, D3, D32, D33, D34: GREEN; LED_0805
F1, F2: 0154003.DRT; Littlefuse_serie_0154; Mouser Part Number 576-0154003.DRT
FL1, FL2: BNX012-01; BNX01201; Mouser Part Number 81-BNX012-01
IC1: NJM78L12UA-TE1; NJM78L12UATE1; Mouser Part Number 513-NJM78L12UA-TE1
IC2: NJM79L12SU3-TE1; Mouser Part Number 513-NJM78L12UA-TE1
IC3: TSR_0.5-2450; TSR-0.5-2433; Mouser Part Number 495-TSR0.5-2450
J1: 39-29-9043; 39-29-904Y
JP1: SolderJumper_2_Bridged; SolderJumper-2_P1.3mm_Bridged2Bar_Pad1.0x1.5mm
L1: SRR4828A-8R2Y; SRR4828A120M; Mouser Part Number 652-SRR4828A-8R2Y
R1, R2: 4K7; R_0805_2012Metric_Pad1.20x1.40mm_HandSolder
R3: 870R; R_0805_2012Metric_Pad1.20x1.40mm_HandSolder
R77, R78: 2K2; R_0805_2012Metric_Pad1.20x1.40mm_HandSolder
R79: 680R; R_0805_2012Metric_Pad1.20x1.40mm_HandSolder
TP1, TP4, TP5, TP6, TP7, TP9: 5000; TP_5001; Mouser Part Number 534-5000
TP3: 5001; TP_5001; Mouser Part Number 534-5001
U1: NCP1117ST33T3G; SOT-223-3_TabPin2

Connections:
+3V3: C16.1 (+), C17.1, D34.2 (A), TP7.1 (1_1), U1.2 (VO); also elsewhere on the board
+5V: C14.1 (+), C15.1, D3.2 (A), IC3.3 (+VOUT), TP6.1 (1_1), U1.3 (VI); also elsewhere on the board
+12V: C7.1 (+), C9.1, D32.2 (A), IC1.1 (OUT), TP4.1 (1_1); also elsewhere on the board
+24V: C1.1, C2.1, C11.1 (+), C12.1, D1.2 (A), FL1.2 (OUTPUT), IC1.3 (IN), L1.1, TP1.1 (1_1); also elsewhere on the board
-12V: C8.2 (-), C10.2, D33.1 (K), IC2.3 (OUT), TP5.1 (1_1); also elsewhere on the board
-24V: C4.2, C5.2, D2.1 (K), FL2.4 (GND_OUT1), FL2.5 (GND_OUT2), FL2.6 (GND_OUT3), IC2.2 (IN), TP9.1 (1_1); also elsewhere on the board
/POWER/+B1: F1.1, J1.3
/POWER/+B2: F2.1, J1.4
/POWER/-B1: FL1.3 (GND_INPUT), J1.1
/POWER/-B2: FL2.3 (GND_INPUT), J1.2
GND: C11.2 (-), C12.2, C13.2 (-), C14.2 (-), C15.2, C16.2 (-), C17.2, IC3.2 (GND), JP1.2 (B), R3.2, R79.2, TP3.1 (1_1), U1.1 (GND); also elsewhere on the board
GNDPWR: C1.2, C2.2, C4.1, C5.1, C7.2 (-), C8.1 (+), C9.2, C10.1, FL1.4 (GND_OUT1), FL1.5 (GND_OUT2), FL1.6 (GND_OUT3), FL2.2 (OUTPUT), IC1.2 (GND), IC2.1 (GND), JP1.1 (A), R1.2, R2.2, R77.2, R78.2; also elsewhere on the board
unnamed: C13.1 (+), IC3.1 (+VIN), L1.2
unnamed: D1.1 (K), R1.1
unnamed: D2.2 (A), R2.1
unnamed: D3.1 (K), R3.1
unnamed: D32.1 (K), R77.1
unnamed: D33.2 (A), R78.1
unnamed: D34.1 (K), R79.1
unnamed: F1.2, FL1.1 (INPUT)
unnamed: F2.2, FL2.1 (INPUT)

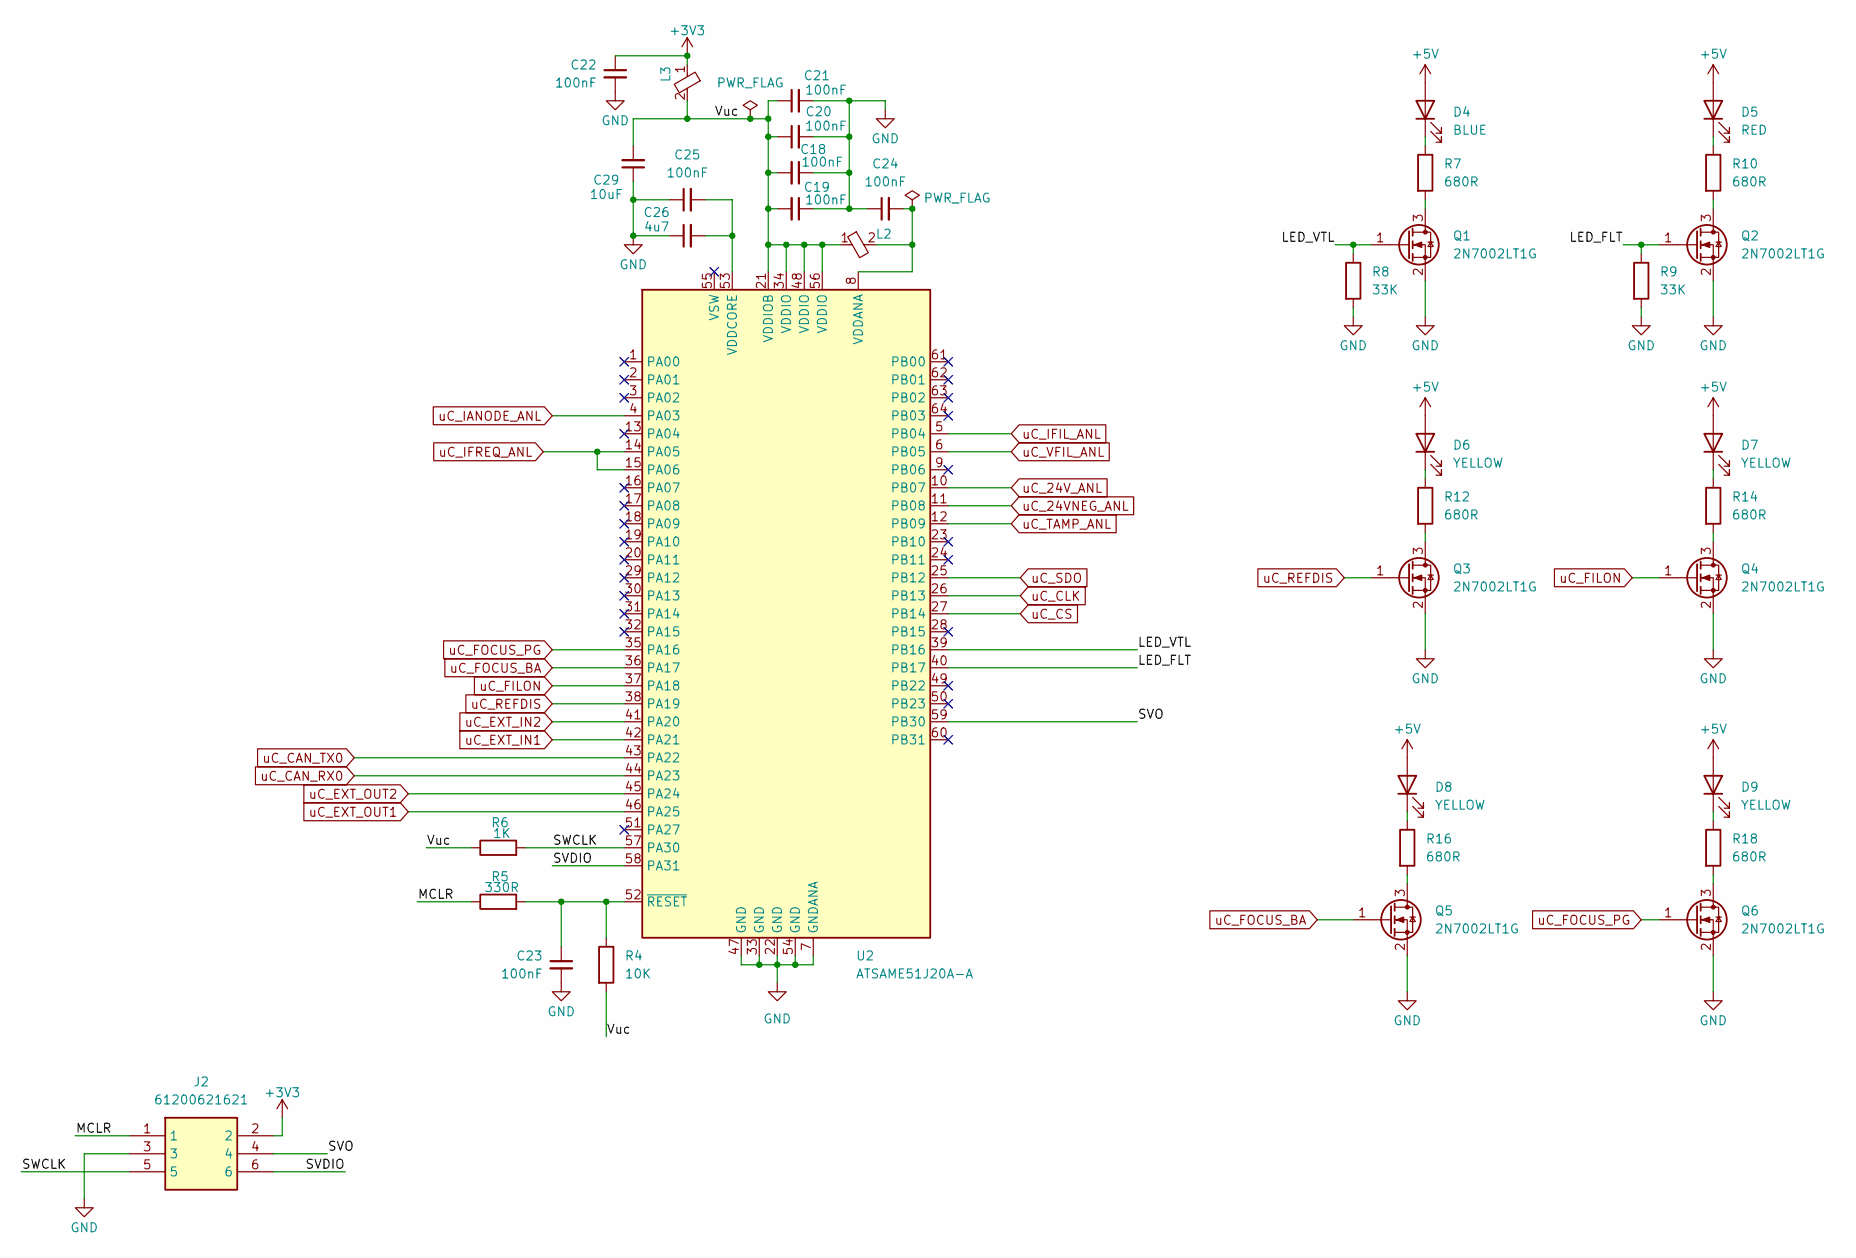
[picture p60: schematic ucontroller.kicad_sch, PCB/25-336-1]

Parts:
C18, C19, C20, C21, C22, C23, C24, C25: 100nF; C_0805_2012Metric_Pad1.18x1.45mm_HandSolder
C26: 4u7; C_0805_2012Metric_Pad1.18x1.45mm_HandSolder; MOUSER 80-C1206C475K6R
C29: 10uF; C_0805_2012Metric_Pad1.18x1.45mm_HandSolder; MOUSER 80-C0805X106K8RAUTLR
D4: BLUE; LED_0805
D5: RED; LED_0805
D6, D7, D8, D9: YELLOW; LED_0805
J2: 61200621621; uCProg_61200621621; Mouser Part Number 710-61200621621
L2, L3: BLM18BD102SN1D; BLM18SP221SN1B; Mouser Part Number 81-BLM18BD102SN1D
Q1, Q2, Q3, Q4, Q5, Q6: 2N7002LT1G; SOT-23; MOUSER 863-2N7002LT1G
R4: 10K; R_0603_1608Metric_Pad0.98x0.95mm_HandSolder
R5: 330R; R_0603_1608Metric_Pad0.98x0.95mm_HandSolder
R6: 1K; R_0603_1608Metric_Pad0.98x0.95mm_HandSolder
R7, R10, R12, R14, R16, R18: 680R; R_0603_1608Metric_Pad0.98x0.95mm_HandSolder
R8, R9: 33K; R_0603_1608Metric_Pad0.98x0.95mm_HandSolder
U2: ATSAME51J20A-A; TQFP-64_10x10mm_P0.5mm

Connections:
+3V3: C22.1, J2.2, L3.1; also elsewhere on the board
+5V: D4.2 (A), D5.2 (A), D6.2 (A), D7.2 (A), D8.2 (A), D9.2 (A); also elsewhere on the board
/uController/LED_FLT: Q2.1 (G), R9.1, U2.40 (PB17)
/uController/LED_VTL: Q1.1 (G), R8.1, U2.39 (PB16)
/uController/MCLR: J2.1, R5.1
/uController/SVDIO: J2.6, U2.58 (PA31)
/uController/SVO: J2.4, U2.59 (PB30)
/uController/SWCLK: J2.5, R6.2, U2.57 (PA30)
/uController/Vuc: C18.2, C19.2, C20.1, C21.1, C29.2, L2.1, L3.2, R4.2, R6.1, U2.21 (VDDIOB), U2.34 (VDDIO), U2.48 (VDDIO), U2.56 (VDDIO)
GND: C18.1, C19.1, C20.2, C21.2, C22.2, C23.2, C24.1, C25.1, C26.1, C29.1, J2.3, Q1.2 (S), Q2.2 (S), Q3.2 (S), Q4.2 (S), Q5.2 (S), Q6.2 (S), R8.2, R9.2, U2.7 (GNDANA), U2.22 (GND), U2.33 (GND), U2.47 (GND), U2.54 (GND); also elsewhere on the board
unnamed: D4.1 (K), R7.1
unnamed: D5.1 (K), R10.1
unnamed: D6.1 (K), R12.1
unnamed: D7.1 (K), R14.1
unnamed: D8.1 (K), R16.1
unnamed: D9.1 (K), R18.1
unnamed: Q1.3 (D), R7.2
unnamed: Q2.3 (D), R10.2
unnamed: Q3.3 (D), R12.2
unnamed: Q4.3 (D), R14.2
unnamed: Q5.3 (D), R16.2
unnamed: Q6.3 (D), R18.2
unnamed: C24.2, L2.2, U2.8 (VDDANA)
unnamed: C25.2, C26.2, U2.53 (VDDCORE)
unnamed: C23.1, R4.1, R5.2, U2.52 (~RESET)
uC_24VNEG_ANL: U2.11 (PB08); also elsewhere on the board
uC_24V_ANL: U2.10 (PB07); also elsewhere on the board
uC_CAN_RX0: U2.44 (PA23); also elsewhere on the board
uC_CAN_TX0: U2.43 (PA22); also elsewhere on the board
uC_CLK: U2.26 (PB13); also elsewhere on the board
uC_CS: U2.27 (PB14); also elsewhere on the board
uC_EXT_IN1: U2.42 (PA21); also elsewhere on the board
uC_EXT_IN2: U2.41 (PA20); also elsewhere on the board
uC_EXT_OUT1: U2.46 (PA25); also elsewhere on the board
uC_EXT_OUT2: U2.45 (PA24); also elsewhere on the board
uC_FILON: Q4.1 (G), U2.37 (PA18); also elsewhere on the board
uC_FOCUS_BA: Q5.1 (G), U2.36 (PA17); also elsewhere on the board
uC_FOCUS_PG: Q6.1 (G), U2.35 (PA16); also elsewhere on the board
uC_IANODE_ANL: U2.4 (PA03); also elsewhere on the board
uC_IFIL_ANL: U2.5 (PB04); also elsewhere on the board
uC_IFREQ_ANL: U2.14 (PA05), U2.15 (PA06); also elsewhere on the board
uC_REFDIS: Q3.1 (G), U2.38 (PA19); also elsewhere on the board
uC_SDO: U2.25 (PB12); also elsewhere on the board
uC_TAMP_ANL: U2.12 (PB09); also elsewhere on the board
uC_VFIL_ANL: U2.6 (PB05); also elsewhere on the board

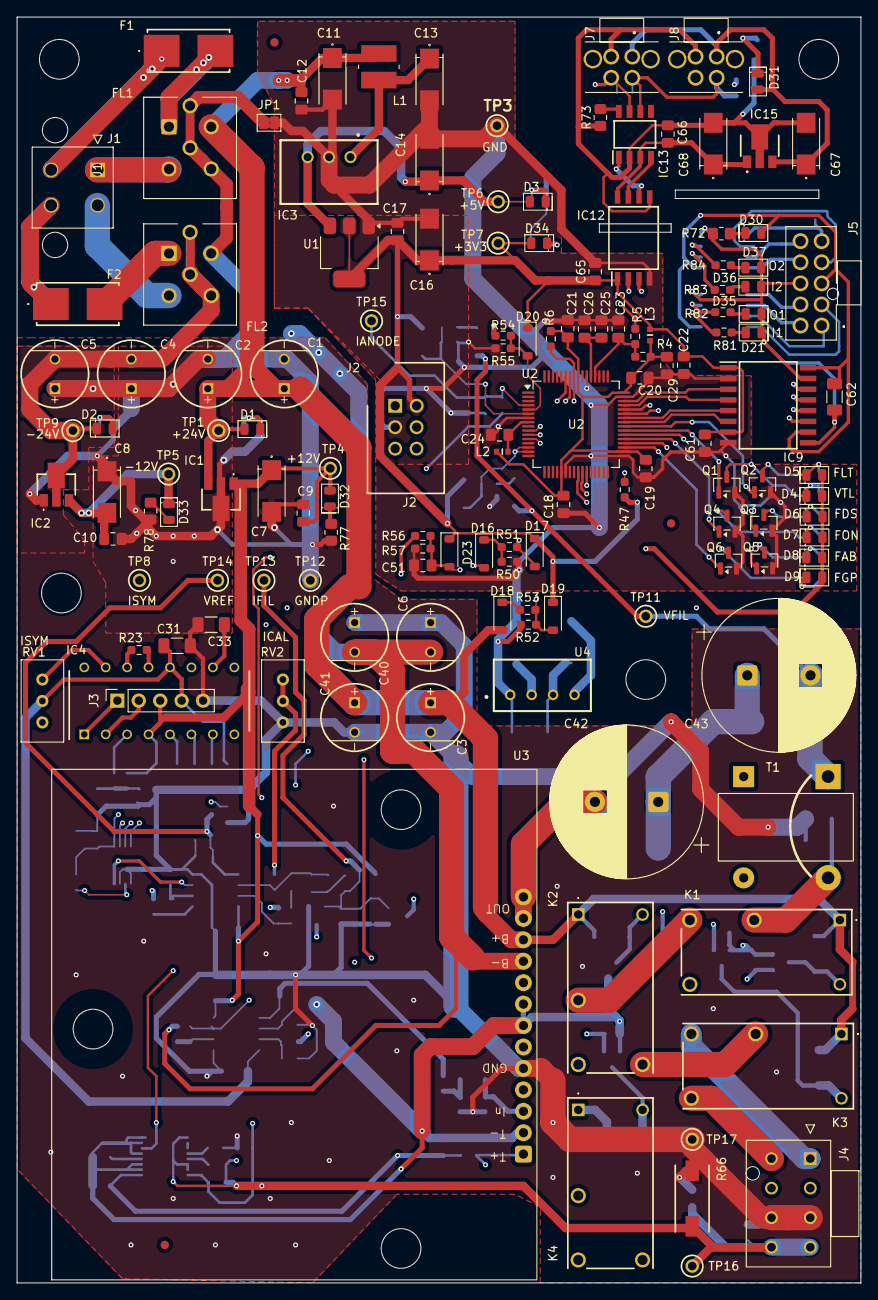
[picture p61: board KiCad/PCB336.kicad_pcb from above]

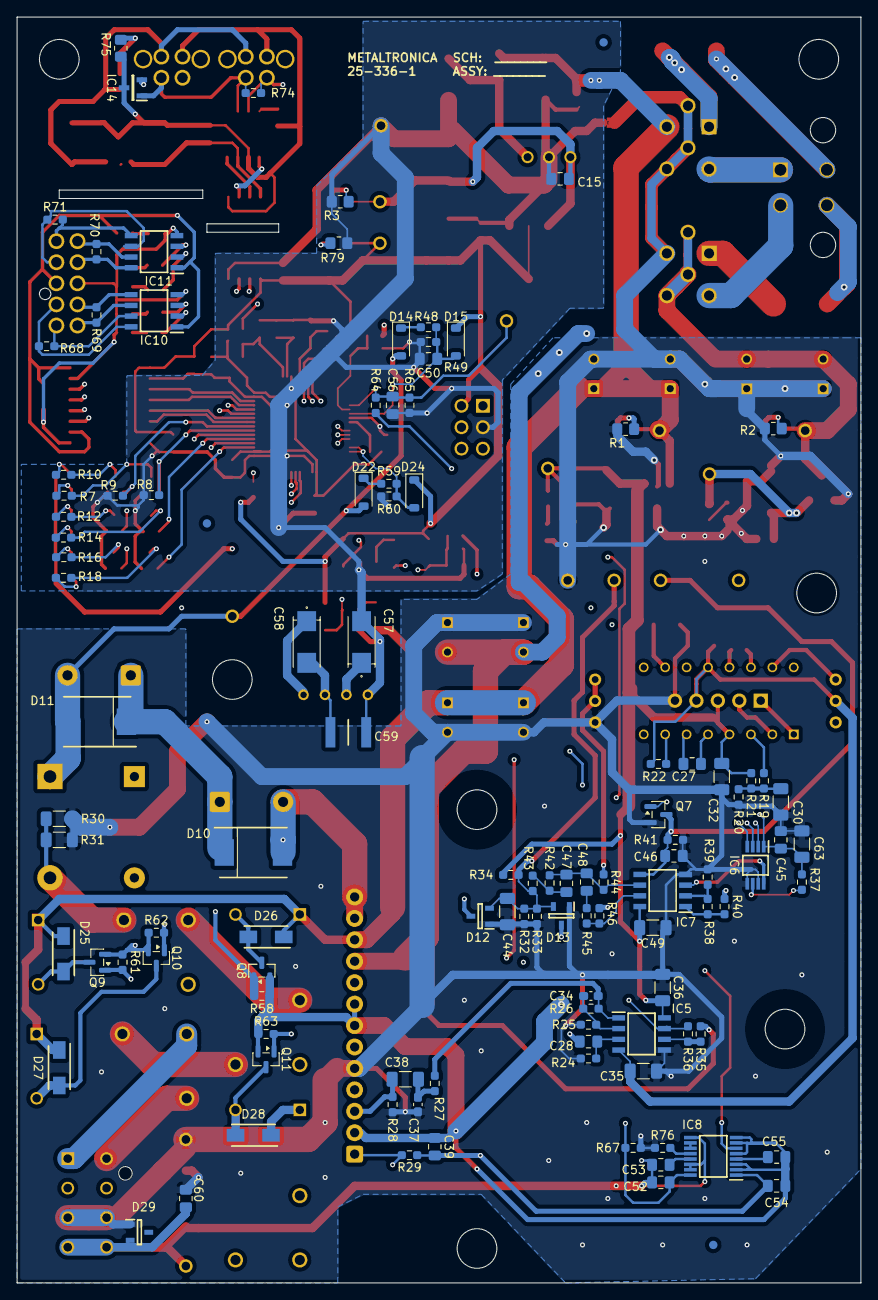
[picture p62: board KiCad/PCB336.kicad_pcb from below]

Board: 4 copper layers, 100.0 x 150.0 mm, 250 parts (110 on the bottom side), 150 nets.
