marcorispoli/PCB336/(commit log)

2026-01-29 Creazione Progetto
    [25-336-0.DSN, 25-336-0.opj, LIBRARY.OLB]
2026-01-29 Aggiornato schema boost
    [25-336-0.DSN, 25-336-0.opj]
2026-02-11 Aggiornato Boost e aggiunto relè filamenti
    [25-336-0.DSN, 25-336-0.opj]
2026-02-13 Completato Boost e Load
    [25-336-0.DSN, 25-336-0.opj, library.opj]
2026-02-13 Completato Schematico Manca da completare la revisione della lista parti
    [25-336-0.DSN, 25-336-0.opj]
2026-02-17 Aggiunto Filtro Ingresso e predisposizione SIL per tensione di griglia
    [25-336-0.DSN, 25-336-0.opj]
2026-02-19 Modificato schematico su richiesta Osvaldina
    [25-336-0.DSN, 25-336-0.dwg, 25-336-0.opj]
2026-02-23 Formattata la lista parti
    [LP25-336-0.xlsx, LP25-336-0_ASSY00_Rev00.xlsx]
2026-04-17 Modificato Lista parti: mancava L1
    [25-336-0.opj, LP25-336-0_ASSY00_Rev00.xlsx]
2026-07-01 Completato Schematico
    [25-336-0.DSN, 25-336-0.opj, LIBRARY.OLB]
2026-07-02 Aggiornata lista parti
    [25-336-0.DSN, 25-336-0.opj]
2026-08-03 Aggiunta sezione KiCad
    [25-336-0.opj, 39-29-6108.stp, 39-30-1102.stp, 39-31-0120.stp, IXFN38N100P.stp, MOLEX-389690002.step, MOLEX_39-29-1108.stp, MOLEX_MINIFIT_87427-1012.stp]
2026-08-03 Inserita pagina Power
    [39-29-9043.stp, BNX012-01.stp, Littlefuse_serie_xxx154.DRT.stp, NJM78L12UA-TE1.stp, PCB336.kicad_pcb, PCB336.kicad_sch, SRR4828A-8R2Y.stp, T491C475K035AT.stp]
2026-08-05 Aggiunto pagina uC
    [25-336-0.opj, BLM18BD102SN1D.stp, uCProg_61200621621.stp, ucontroller.kicad_sch]
2026-08-05 Filament Pagina in lavorazione
    [25-336-0.opj, PCB336.kicad_pcb, PCB336.kicad_sch, XR2206CP-F.stp, filamentcontrol.kicad_sch, power.kicad_sch, ucontroller.kicad_sch]
2026-08-30 Avanzamenti in Agosto
    [25-336-0.opj, PCB336.kicad_pcb, power.kicad_sch]
2026-09-01 Completato Filament e Monitor
    [25-336-0.opj, PCB336.kicad_pcb, PCB336.kicad_sch, filamentcontrol.kicad_sch, monitor.kicad_sch, power.kicad_sch, ucontroller.kicad_sch]
2026-09-09 Completato schematico, e ERC Iniziato piazzamento
    [25-336-0.DSN, 25-336-0.opj, PCB336.kicad_pcb, PCB336.kicad_sch, can_bus.kicad_sch, externalsynch.kicad_sch, filamentcontrol.kicad_sch, load.kicad_sch]
2026-09-13 Iniziato loi sbroglio
    [PCB336.kicad_pcb, externalsynch.kicad_sch, filamentcontrol.kicad_sch, load.kicad_sch, monitor.kicad_sch, power.kicad_sch, ucontroller.kicad_sch]
2026-09-16 Lavoro su BOM
2026-09-17 Modificato driver per Can Bus (1057 NXP) Creata BOM per 3 schede Mouser
